moroz-matros/badminton_training_diplom/наброски/cyclops.jpg

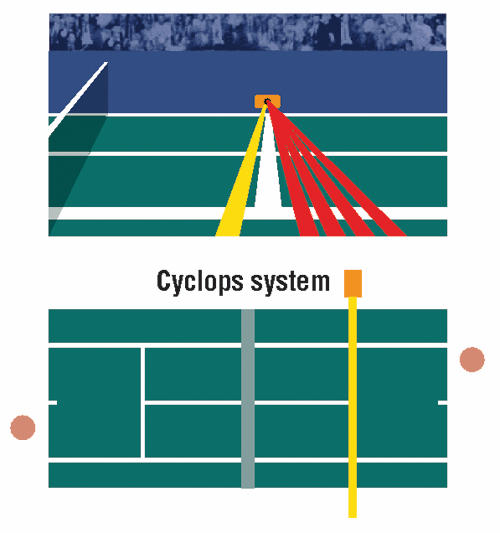
наброски/cyclops.jpg
