moroz-matros/badminton_training_diplom/курсовая/Безымянный.png

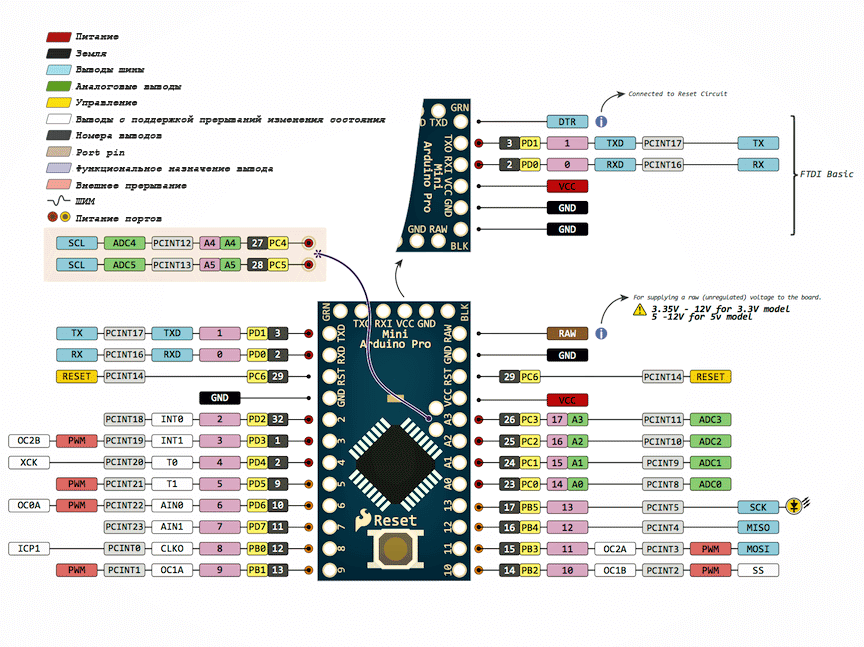
курсовая/Безымянный.png
