moroz-matros/badminton_training_diplom/README.md

# badminton_training_diplom

список материалов - https://docs.google.com/spreadsheets/d/1XVWoqVWHNPgPeewf001gxFfqlMmKqkPSv3BXijBLTfs/edit?usp=sharing
Опросы в процессе
