moroz-matros/badminton_training_diplom/прототип и практика/отчет_v1.docx

СОДЕРЖАНИЕ

Введение.......................................................................................................................4

Основная часть.............................................................................................................5

1 Проектирование и сборка макетного образца.............................................5

  1.1 Микроконтроллер ATmega328.........................................................5
  1.2 Чувствительный к давлению мат.....................................................6
  1.3 Пайка элементов................................................................................7
  1.4 Сборка схемы.....................................................................................7

2 Программирование макетного образца........................................................9

Заключение.................................................................................................................10

Список использованных источников.......................................................................11

ВВЕДЕНИЕ

В настоящее время сложно представить современный мир без повсеместного использования различных систем с датчиками — двери в торговых центрах открываются автоматически при приближении человека, а система «умный дом» уже не является чем-то необычным. Часто встречаются и системы с датчиками, воспринимающими нажатия, приложенное давление.

Целью данной практики является разработка макетного образца чувствительного мата на основе материала Velostat®.

Для достижения данной цели были поставлены следующие задачи:

1. Ознакомиться с процессом пайки электронных компонентов, изучить технику безопасности;
2. На основе медной ленты и материала Velostat® собрать макетный образец чувствительного мата, подключить его к микроконтроллеру.
3. Запрограммировать микроконтроллер на заданное в техническом задании поведение.

ОСНОВНАЯ ЧАСТЬ

1 Проектирование и сборка макетного образца

Макетный образец состоит из двух частей — самого мата и микроконтроллера, определяющего его поведение.

  1.1 Микроконтроллер ATmega328

Существует огромное множество различных микроконтроллеров. Однако работать непосредственно только с микросхемой может быть затруднительно, поэтому часто встречаются уже готовые модули на плате.

Одной из наиболее известных марок в этой области является Arduino. Она предоставляет программную оболочку для написания программ и аппаратную часть, включающую в себя набор смонтированных печатных плат. По Arduino есть большое количество теоретического материала, сторонние производители также выпускают различные датчики и другие периферийные устройства, которые ориентированы на подключение к устройствам данной марки. Поэтому было принято решение использовать их.

В классической линейке устройств в основном применяются микроконтроллеры семейства Atmel AVR — ATmega2560, ATmega32U4, ATmega328, ATtiny85, ATmega168. В данной работе было решено использовать плату с микроконтроллером ATmega328.

ATmega328 — 8-битный микроконтроллер с низким энергопотреблением, созданный по КМОП технологии. В нем используется усовершенствованная компанией AVR RISC архитектура, предполагающая сокращение числа команд.

Этот микроконтроллер используется в платформе Arduino Pro Mini, в данной работе была использована именно она. Среди остальной линейки серии она отличается маленьким размером. Также Arduino Pro Mini отличается удовлетворительным соотношением цены к техническим требованиям для разработанного мата.

Данная плата обладает характеристиками, представленными в таблице 1.

Таблица 1 — Характеристики платформы Arduino Pro Mini

Характеристика | Значение
Рабочее напряжение | 5 В
Входное напряжение | 5-12 В
Цифровые входы/выходы | 14 (6 из которых могут использоваться как выходы ШИМ
Аналоговые входы | 6
Постоянный ток через вход/выход | 40 мА
Флеш-память | 16 Кб (2 используются для загрузчика)
ОЗУ | 1 Кб
EEPROM | 512 байт
Тактовая частота | 16 МГц

Питание платы в данной работе осуществляется от компьютера с помощью переходника USB в TTL.

Внешний вид платы представлен на рисунке 1.

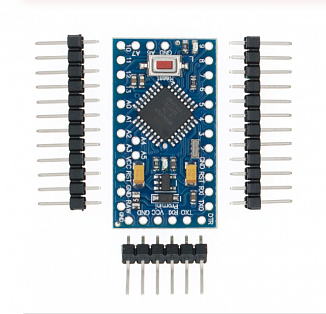
[picture p3: figure]

Рисунок 1 — Внешний вид контроллера Arduino Pro Mini

  1.2 Чувствительный к давлению мат

Velostat® представляет собой непрозрачную объемно-проводящую пленку, наполненную полиолефином. Активное сопротивление материала уменьшается при приложении давления. Если материал расположить между двумя проводящими слоями, можно использовать его в качестве датчика давления.

В качестве проводящих слоев использована лента из меди, которая обычно используется как электрический проводник.

Таким образом, строение мата представляет из себя следующее: лист материала Velostat® располагается между рядами лент из меди. К листам меди припаиваются провода. К одному слою поступает питание, провода со второго слоя поступают на аналоговые входы собранной схемы.

Таким образом, схема самого мата выглядит примерно так, как представлено на рисунке 2.

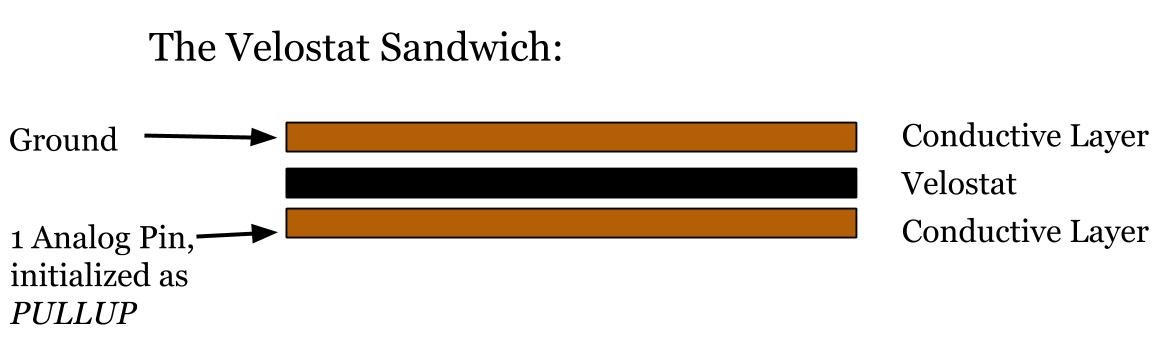
[picture p4: figure]

Рисунок 2 — Основа макетного образца мата

Однако у Arduino Pro Mini есть только 6 аналоговых входов. Для увеличения их количества было принято решение использовать мультиплексор и демультиплексор.

Наиболее часто используемой в системах Arduino микросхемой является 16-канальный мультиплексор/демультиплексор CD74HC4067. Он также поставляется на плате, что облегчает его подключение к микроконтроллеру Arduino. Внешний вид CD74HC4067 представлен на рисунке 3.

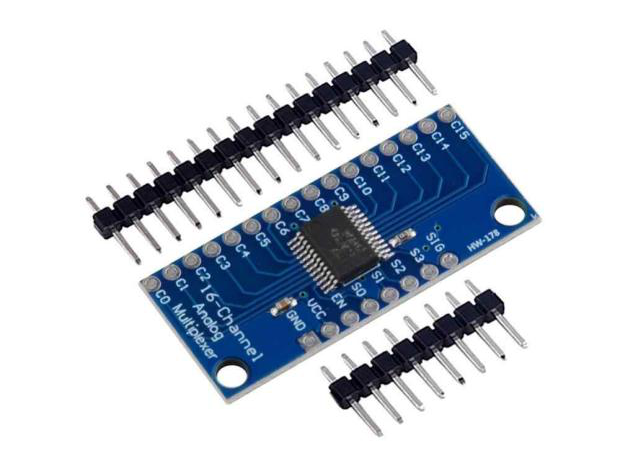
[picture p5: figure]

Рисунок 3 — 16-канальный мультиплексор/демультиплексор CD74HC4067

Технические параметры устройства (рабочая температура, напряжение питания) подходят под условия разработанного макетного образца.

1.3 Пайка элементов

Пайка — технологическая операция, применяемая для получения неразъёмного соединения деталей из различных материалов путём введения между этими деталями расплавленного материала (припоя), имеющего более низкую температуру плавления, чем материал (материалы) соединяемых деталей.

Во время пайки в воздух выделяются такие вредные вещества, как свинец, цинк и др., поэтому место работы должно хорошо проветриваться.

Необходимо было спаять следующие элементы:

1. Провода и штыревые соединители;
2. Провода и медную ленту;
3. Плату Arduino и штыревые соединители.

В процессе пайки использовался припой оловянно-свинцовый с флюсом (Sn63/Pb37, содержание флюса: 2%).

1.4 Сборка схемы

После выполнения пайки элементов необходимо было собрать схему устройства. Для удобства использовали макетную плату, изображение которой представлено на рисунке 4.

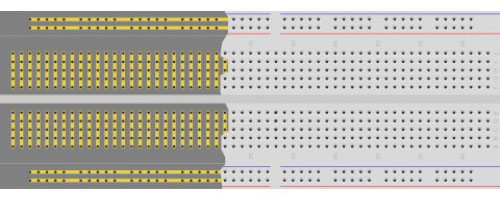
[picture p6: figure]

Рисунок 4 — Макетная плата на 830 контактов и её внутреннее строение

Принцип работы устройства следующий: с выходов платы микроконтроллера на 16-канальный аналоговый мультиплексор/демультиплексор CD74HC4067, работающий в режиме демультиплексора, поступают сигналы S0_OUTPUT...S3_OUTPUT и SIG_OUTPUT. С помощью первых четырех сигналов выбирается один из 16 C0_OUTPUT...C15_OUTPUT, на который будет подаваться сигнал SIG_OUTPUT. К выходам C0_OUTPUT..C11_OUTPUT подключены 12 линий медной ленты. Ток проходит по ленте через Velostat® и поступает на другие 12 линий медной ленты, которые подсоединены к выходам C0_INPUT...C11_INPUT мультиплексора. С помощью сигналов S0_INPUT...S3_INPUT аналогично производится выбор нужного канала, сигнал с которого через выход SIG_INPUT поступает на вход платы микроконтроллера.

Таким образом, выбирав нужный канал и зафиксировав изменение поступающего аналогового сигнала, можно отследить нажатия на собранный датчик.

2 Программирование макетного образца

Язык программирования Arduino называется Arduino C и представляет собой язык C++ (https://ru.wikipedia.org/wiki/C++) с фреймворком (https://ru.wikipedia.org/wiki/%D0%A4%D1%80%D0%B5%D0%B9%D0%BC%D0%B2%D0%BE%D1%80%D0%BA) Wiring (https://en.wikipedia.org/wiki/Wiring_(development_platform)) (https://ru.wikipedia.org/wiki/Arduino), Он имеет некоторые отличия по части написания кода, который компилируется и собирается с помощью avr-gcc (https://ru.wikipedia.org/wiki/GNU_Compiler_Collection), с особенностями, облегчающими написание работающей программы — имеется набор библиотек, включающий в себя функции и объекты.

Программирование микроконтроллера ATmega328 с помощью среды разработки Arduino IDE.

Все микроконтроллеры от Arduino имеют специальный загрузчик, созданный на основе Atmel AVR Application Note AN109. Этот загрузчик может работать через интерфейс USB, с его помощью производилось программирование.

Принцип работы системы был описан в пункте 1.4.

Схема алгоритма программного кода представлена на рисунке 6.

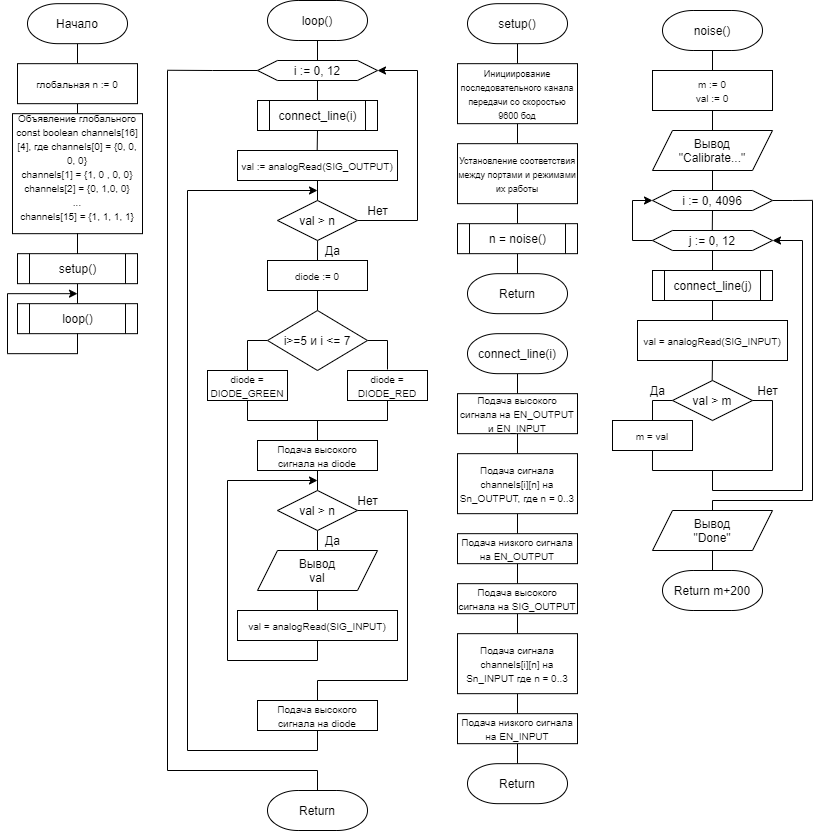
[picture p7: figure]
algo

Рисунок 6 — Схема алгоритма программного кода

Код программы представлен в листинге 1.

Листинг 1 — Код программы макетного образца

#define SIG_OUTPUT A1

#define S3_OUTPUT 13

#define S2_OUTPUT 12

#define S1_OUTPUT 11

#define S0_OUTPUT 10

#define EN_OUTPUT 4

#define SIG_INPUT A0

#define S3_INPUT 9

#define S2_INPUT 8

#define S1_INPUT 7

#define S0_INPUT 6

#define EN_INPUT 5

Продолжение листинга 1

#define DIODE_GREEN 3

#define DIODE_RED 2

int n = 0;

const boolean channels [16][4] {

{0, 0, 0, 0}, //channel 0

{1, 0, 0, 0}, //channel 1

{0, 1, 0, 0}, //channel 2

{1, 1, 0, 0}, //channel 3

{0, 0, 1, 0}, //channel 4

{1, 0, 1, 0}, //channel 5

{0, 1, 1, 0}, //channel 6

{1, 1, 1, 0}, //channel 7

{0, 0, 0, 1}, //channel 8

{1, 0, 0, 1}, //channel 9

{0, 1, 0, 1}, //channel 10

{1, 1, 0, 1}, //channel 11

{0, 0, 1, 1}, //channel 12

{1, 0, 1, 1}, //channel 13

{0, 1, 1, 1}, //channel 14

{1, 1, 1, 1} //channel 15

};

void setup() {

Serial.begin(9600);

pinMode(S0_OUTPUT, OUTPUT);

pinMode(S1_OUTPUT, OUTPUT);

pinMode(S2_OUTPUT, OUTPUT);

pinMode(S3_OUTPUT, OUTPUT);

pinMode(S0_INPUT, OUTPUT);

pinMode(S1_INPUT, OUTPUT);

pinMode(S2_INPUT, OUTPUT);

pinMode(S3_INPUT, OUTPUT);

pinMode(EN_OUTPUT, OUTPUT);

pinMode(EN_INPUT, OUTPUT);

pinMode(SIG_OUTPUT, OUTPUT);

pinMode(SIG_INPUT, INPUT);

pinMode(DIODE_RED, OUTPUT);

pinMode(DIODE_GREEN, OUTPUT);

n = noise();

}

void loop() {

//необходимо пройтись по всем портам S0..S3 выхода и подать на C0..C11 (C16) платы питания высокий сигнал

Продолжение листинга 1

for (int i = 0; i < 12; i++) {

connect_line(i);

int val = analogRead(SIG_INPUT);

if (val > n) {

int diode = 0;

if ((i >= 5) && (i <= 7)){

diode = DIODE_GREEN;

} else {

diode = DIODE_RED;

}

digitalWrite(diode, HIGH);

while (val > n) {

Serial.print(val);

Serial.print(" ");

Serial.println(n);

val = analogRead(SIG_INPUT);

}

digitalWrite(diode, LOW);

}

}

}

int noise() {

int m = 0;

int val = 0;

Serial.println("Calibrate...");

for (int i = 0; i < 4096; i++) {

for (int j = 0; j < 12; j++) {

connect_line(j);

val = analogRead(SIG_INPUT);

if (val > m) {

m = val;

}

}

}

Serial.println("Done");

return m+200;

}

void connect_line(int i) {

digitalWrite(EN_OUTPUT, HIGH);

digitalWrite(EN_INPUT, HIGH);

digitalWrite(S0_OUTPUT, channels[i][0]);

digitalWrite(S1_OUTPUT, channels[i][1]);

digitalWrite(S2_OUTPUT, channels[i][2]);

digitalWrite(S3_OUTPUT, channels[i][3]);

digitalWrite(EN_OUTPUT, LOW);

digitalWrite(SIG_OUTPUT, HIGH);

Продолжение листинга 1

digitalWrite(S0_INPUT, channels[i][0]);

digitalWrite(S1_INPUT, channels[i][1]);

digitalWrite(S2_INPUT, channels[i][2]);

digitalWrite(S3_INPUT, channels[i][3]);

digitalWrite(EN_INPUT, LOW);

}

ЗАКЛЮЧЕНИЕ

В ходе прохождения практики были достигнуты поставленные цели и выполнены следующие задачи:

1. Произведено ознакомление с процессом пайки электронных компонентов, изучена техника безопасности;
2. На основе медной ленты и материала Velostat® был собран датчик давления. Датчик был подключен к микроконтроллеру ATmega328 линейки Arduino.
3. Микроконтроллер запрограммирован на заданное в техническом задании поведение.

Отчет был оформлен в соответствии с ГОСТ 7.32-2017.

СПИСОК ИСПОЛЬЗОВАННЫХ ИСТОЧНИКОВ

1. ГОСТ 7.32-2017. Отчет о научно-исследовательской работе. Структура и правила оформления.
2. Справочник по пайке / Ред. Петрунин И. Е. - 2-е изд., перераб. и дополн. - М. : Машиностроение, 1984. - 398 с.
3. Портал магистров ДонНТУ. Реферат по теме выпускной работы Куксина И.Ю. — URL: https://masters.donntu.org/2013/etf/kuksin/diss/index.htm (дата обращения 2021-07-02)
4. Alterozoom. Velostat. — URL: https://alterozoom.com/ru/documents/43822.html (дата обращения 2021-07-02)
5. Arduino. — URL: https://www.arduino.cc/ (дата обращения 2021-07-12)
6. Arduino.ru. — http://arduino.ru/ (дата обращения 2021-07-12)
7. E-Portfolio for Robotics 243 Workshop Spring 2015. — URL: https://www.sites.google.com/a/mtholyoke.edu/cs-243-spring-15-barkh22g/home (дата обращения 2021-07-02)
