moroz-matros/badminton_training_diplom/наброски/список_использованных_источников.docx

СПИСОК ИСПОЛЬЗОВАННЫХ ИСТОЧНИКОВ

1. TOPSPIN.PRO [Электронный ресурс]. — URL: https://topspin.pro/market/badminton_pushki/ (дата обращения 2022-02-10)
2. Коновалов И.Е. Технология формирования тактико-технических навыков спортсменов в теннисе и бадминтоне с помощью устройств дополненной реальности / И.Е. Коновалов, В.Е. Афоньшин, М.М. Полевщиков // Наука и спорт: современные тенденции. – 2020. – Т. 8, № 1. – С. 19-24. DOI: 10.36028/2308-8826-2019-8-1-19-24
3. The Tech Race. S1 - EP 29 - 20:20 vision: A clear view of Badminton technology (https://olympics.com/en/original-series/episode/20-20-vision-a-clear-view-of-badminton-technology) [Электронный ресурс]. — URL: https://olympics.com/en/original-series/episode/20-20-vision-a-clear-view-of-badminton-technology (дата обращения 2022-02-11)
4. Shreeharsh Kelkar. The Power of Sight: The Case of Hawk-Eye in Tennis (англ.). — 2012. — 14 p.
5. Badminton: How to play, rules, and all you need to know. By Olympic Channel [Электронный ресурс]. — URL: https://olympics.com/en/featured-news/badminton-guide-how-to-play-rules-olympic-history (дата обращения 2022-02-13)
6. Портал магистров ДонНТУ. Реферат по теме выпускной работы Куксина И.Ю. [Электронный ресурс]. — URL: https://masters.donntu.org/2013/etf/kuksin/diss/index.htm (дата обращения 2021-09- 02)
7. Документация на Arduino Pro Mini [Электронный ресурс]. — URL: https://docs.arduino.cc/retired/boards/arduino-pro-mini (дата обращения 2021-10-01)
8. Документация на ATMega328P [Электронный ресурс]. — URL: https://www.microchip.com/content/dam/mchp/documents/MCU08/ProductDocuments/DataSheets/Atmel-7810-Automotive-Microcontrollers-ATmega328P_Datasheet.pdf (дата обращения 2021-10-01)
9. Документация на CD74HC4067 [Электронный ресурс]. — URL: https://www.ti.com/lit/ds/symlink/cd74hc4067.pdf (дата обращения 2021-10-01)
10. Документация на GNL-3012HD [Электронный ресурс]. — URL: https://static.chipdip.ru/lib/773/DOC002773602.pdf (дата обращения 2021-10-01)
11. Документация на резисторы MF [Электронный ресурс]. — URL: https://static.chipdip.ru/lib/336/DOC014336148.pdf (дата обращения 2021-10-01)
12. Документация на резисторы СF [Электронный ресурс]. — URL: https://static.chipdip.ru/lib/336/DOC014336146.pdf (дата обращения 2021-10-01)
13. Документация на HC-05 [Электронный ресурс]. — URL: http://wiki.amperka.ru/_media/продукты:troyka-bluetooth:troyka-bluetooth_datasheet.pdf (дата обращения 2021-10-01)
14. Электронный модуль «Bluetooth модуль HC-05». Технические данные и руководство пользователя [Электронный ресурс]. — URL: https://academy.evolvector.ru/baza/datasheet/%D0%9F%D0%AD%D0%9C100061-Bluetooth.pdf (дата обращения 2021-10-01)
15. Самые популярные операционные системы мира 2020 [Электронный ресурс]. — URL: https://marketer.ua/stats-operating-system-2020/ (дата обращения 2022-02-10)
16. Android Developers [Электронный ресурс]. — URL: https://developer.android.com/ (дата обращения 2022-02-10)
17. Как выбрать язык программирования для создания Андроид — приложения [Электронный ресурс]. — URL: https://habr.com/ru/post/477578/ (дата обращения 2022-02-10)
18. Android Developers [Электронный ресурс]. — URL: https://developer.android.com/ (дата обращения 2022-02-12)
19. Kotlin vs Java [Электронный ресурс]. — URL: https://www.imaginarycloud.com/blog/kotlin-vs-java/#1 (дата обращения 2022-02-12)
20. Иванова Г.С., Ничушкина Т.Н. Тестирование программного обеспечения. Методические указания по выполнению лабораторной работы по дисциплине «Технология разработки программных систем». — 2019. — 13с.
22. ГОСТ 2.730-73. Единая система конструкторской документации. Обозначения условные графические в схемах. Приборы полупроводниковые.
23. ГОСТ 2.728-74. Единая система конструкторской документации. Обозначения условные графические в схемах. Резисторы, конденсаторы.
24. ГОСТ 2.710-81. Единая система конструкторской документации. Обозначения буквенно-цифровые в электрических схемах.
25. ГОСТ 2.755-87. Единая система конструкторской документации. Обозначения условные графические в схемах. Устройства коммутационные и контактные соединения.
26. ГОСТ 2.702-2011. Единая система конструкторской документации. Правила выполнения электрических схем.
27. ГОСТ 7.32-2017. Отчет о научно-исследовательской работе. Структура и правила оформления.
28. Android [Электронный ресурс]. — URL: https://www.android.com/ (дата обращения 2022-02-12)

https://www.youtube.com/watch?v=cT1xw9p7Xek

https://www.youtube.com/watch?v=0W7FqDBD7Ts

https://www.proquest.com/openview/b7639530b4d56040ad19f7377a0a700b/1.pdf?pq-origsite=gscholar&cbl=40505

Electronic linesmen (https://go.gale.com/ps/i.do?id=GALE|A12842873&sid=googleScholar&v=2.1&it=r&linkaccess=abs&issn=00256501&p=AONE&sw=w)

L O'Connor - Mechanical Engineering-CIME, 1992 - go.gale.com

http://tvskit.narod.ru/stati/stati21/stati21.html
