moroz-matros/badminton_training_diplom/наброски/спецификация_2.pdf

Поз. обозначение | Наименование | Кол. | Примечание
| Устройства коммутационные
SW1, SW2 | Кнопка с самовозвратом SW-B3U-1000P | 2
| Диоды
VD1 | Диод Шоттки IN5817 | 1
| Транзисторы
VT1, VT2 | Транзистор биполярный NPN MJD112-LGE | 2

Подп. дата

Инв. №

дубл. Взам. инв. №

Подп. и

дата

Программно-аппаратная система контроля попаданий волана в заданную зону бадминтонной площадки

Изм. Лист | | № докум. | Подп. | Дата
| | | | | Спецификация | Лит. | Лист | Листов
Пров. | Сотников А.А. | | | | | | 2 | 2

Инв. №

подл. Разраб. Морозова А.А

МГТУ им. Н.Э. Баумана
Кафедра ИУ6
Группа ИУ6-82Б
Н. контр. | Еремин О.Ю. Утв. | Формат А4
