moroz-matros/badminton_training_diplom/курсовая/func.png

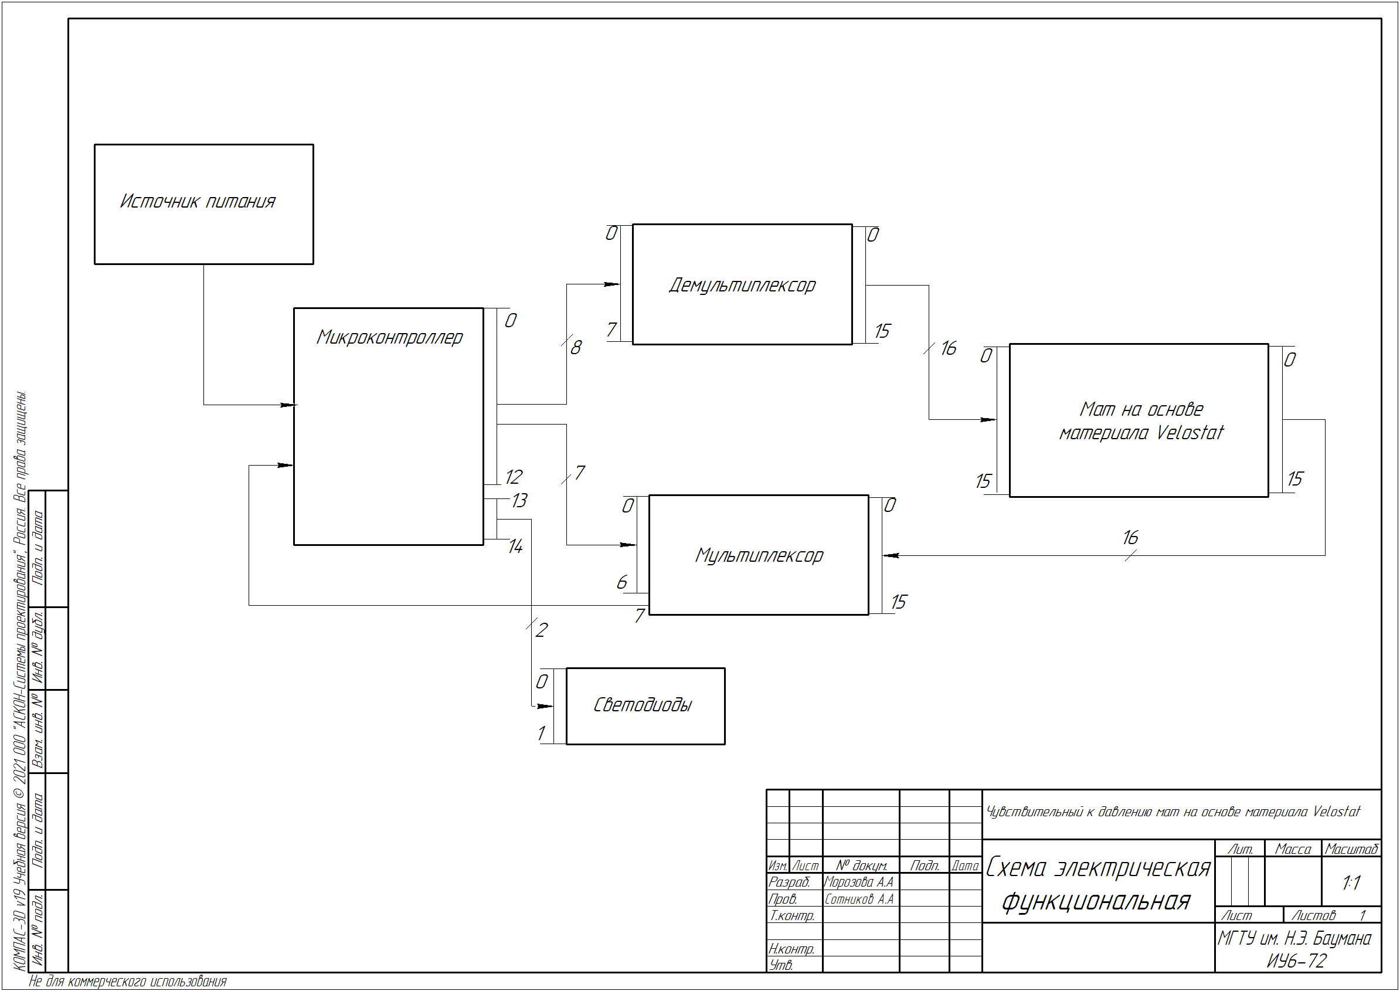
курсовая/func.png
