moroz-matros/badminton_training_diplom/курсовая/princ_v2.png

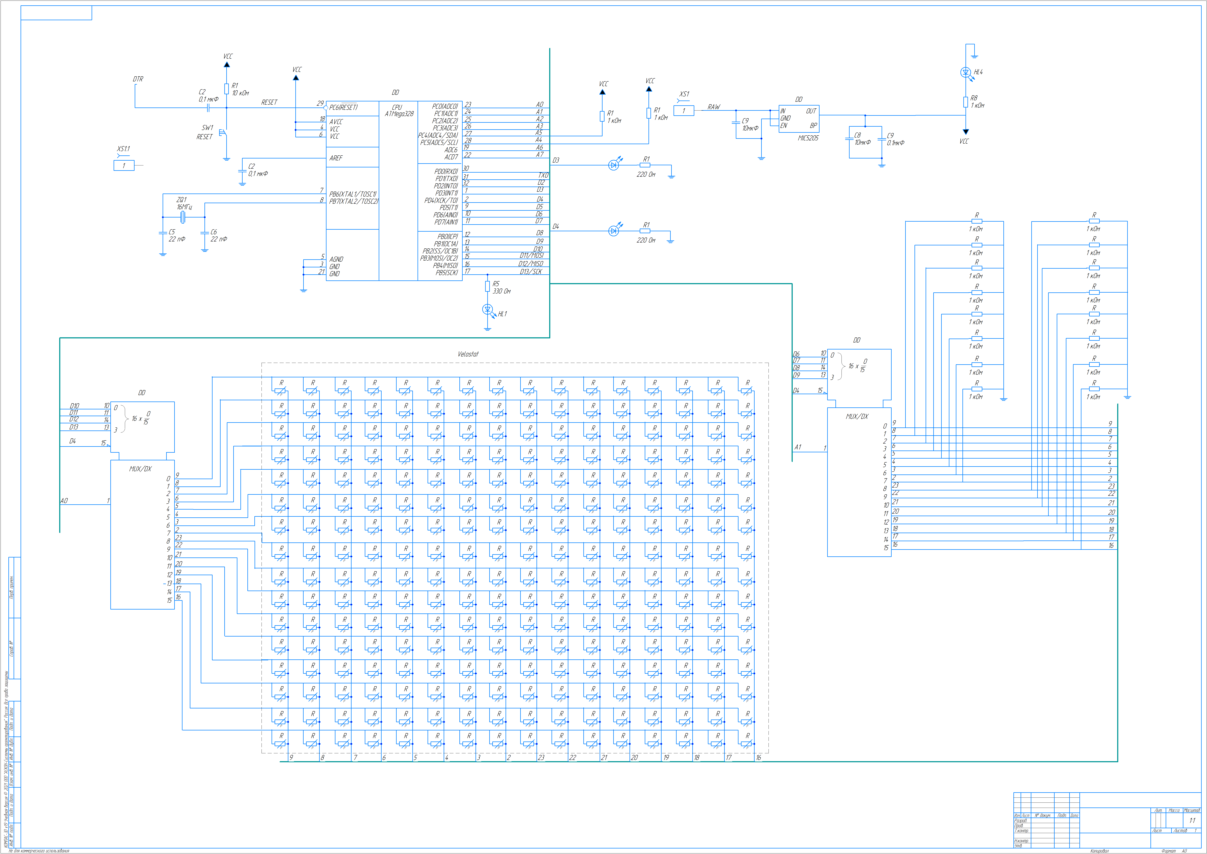
курсовая/princ_v2.png
