moroz-matros/badminton_training_diplom/курсовая/princ_v3.png

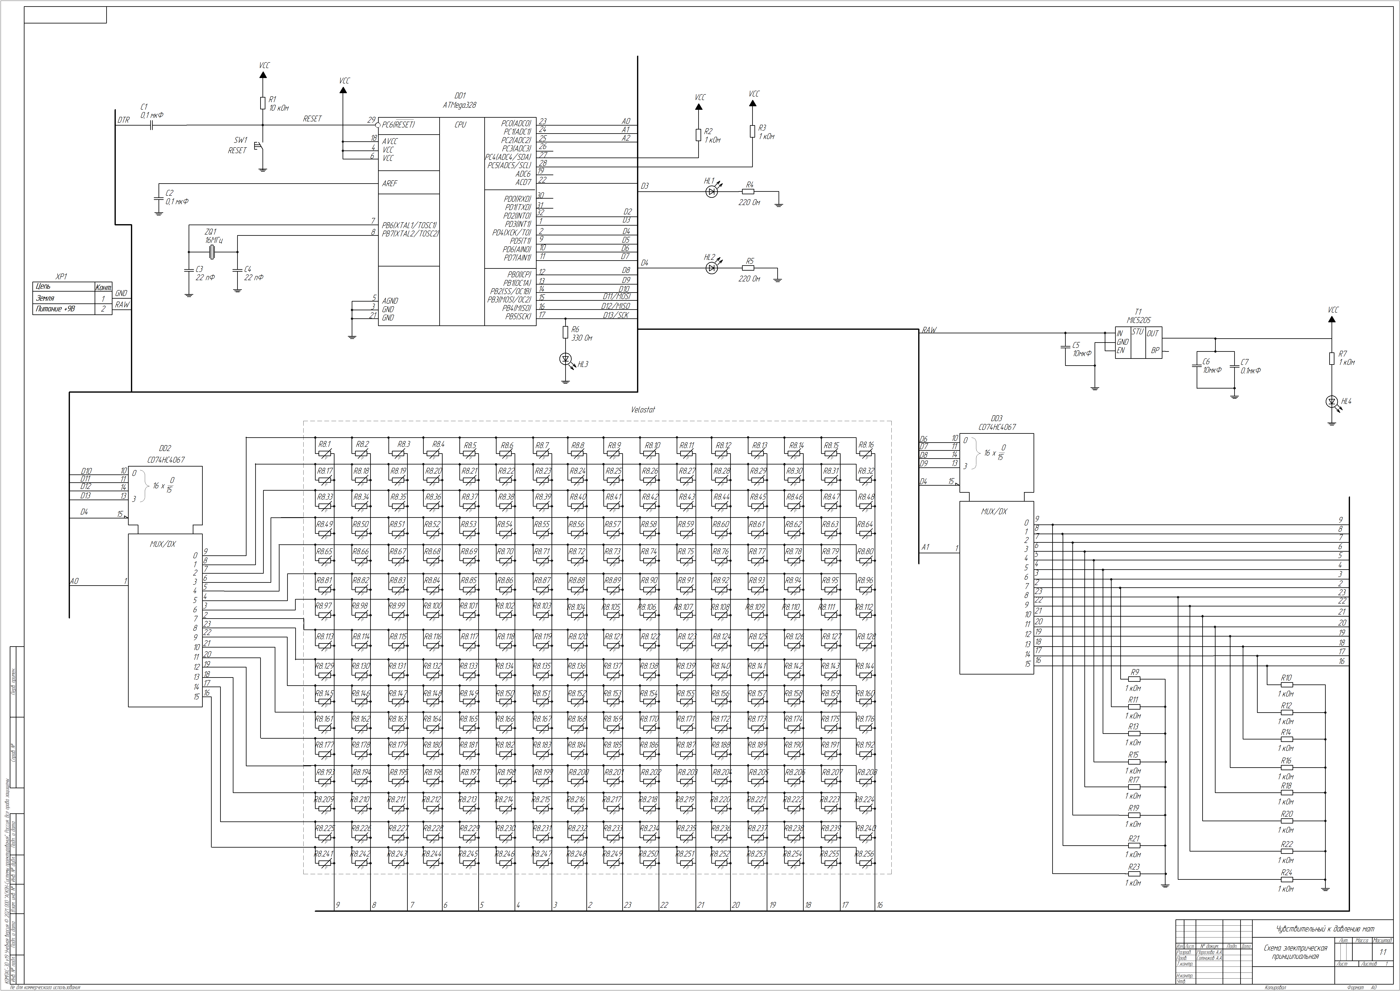
курсовая/princ_v3.png
