moroz-matros/badminton_training_diplom/курсовая/пример_структурная.png

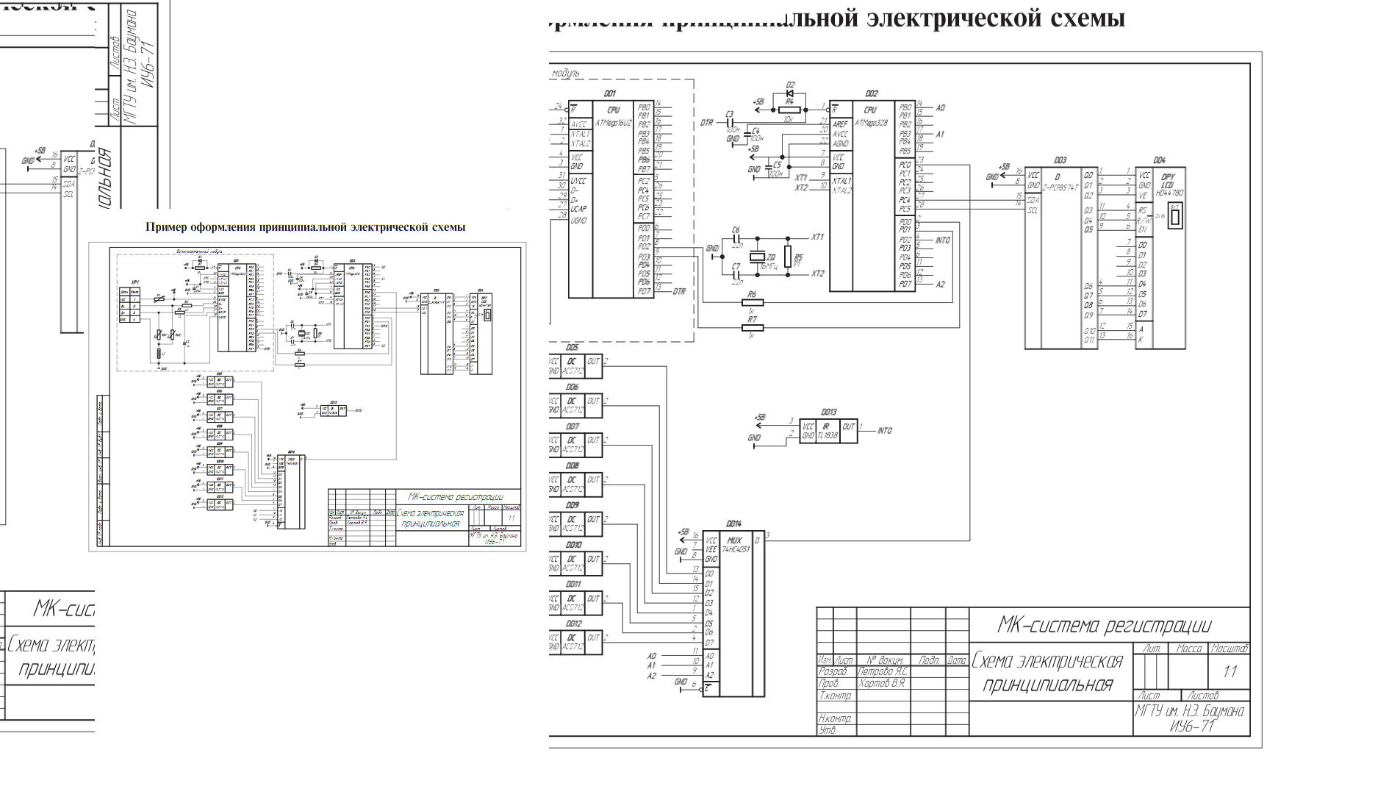
курсовая/пример_структурная.png
