moroz-matros/badminton_training_diplom/курсовая/пример_функциональная.png

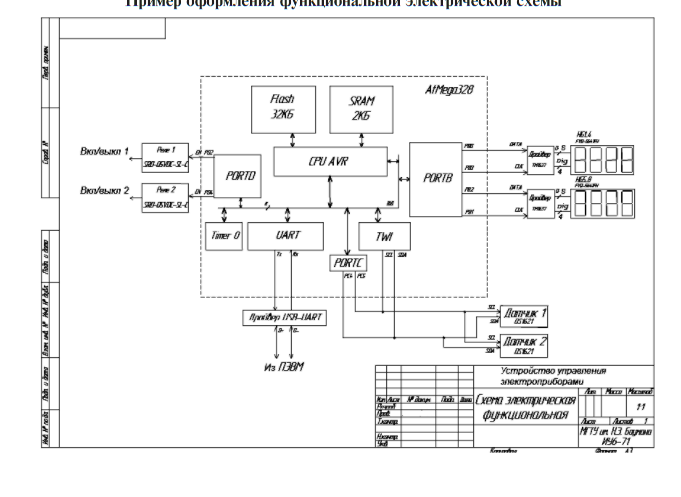
курсовая/пример_функциональная.png
