moroz-matros/badminton_training_diplom/курсовая/Снимок.PNG

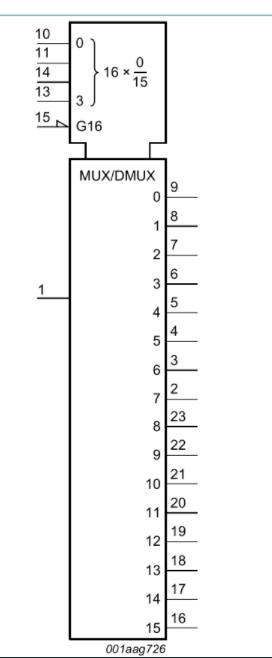
курсовая/Снимок.PNG
