moroz-matros/badminton_training_diplom/наброски/func.png

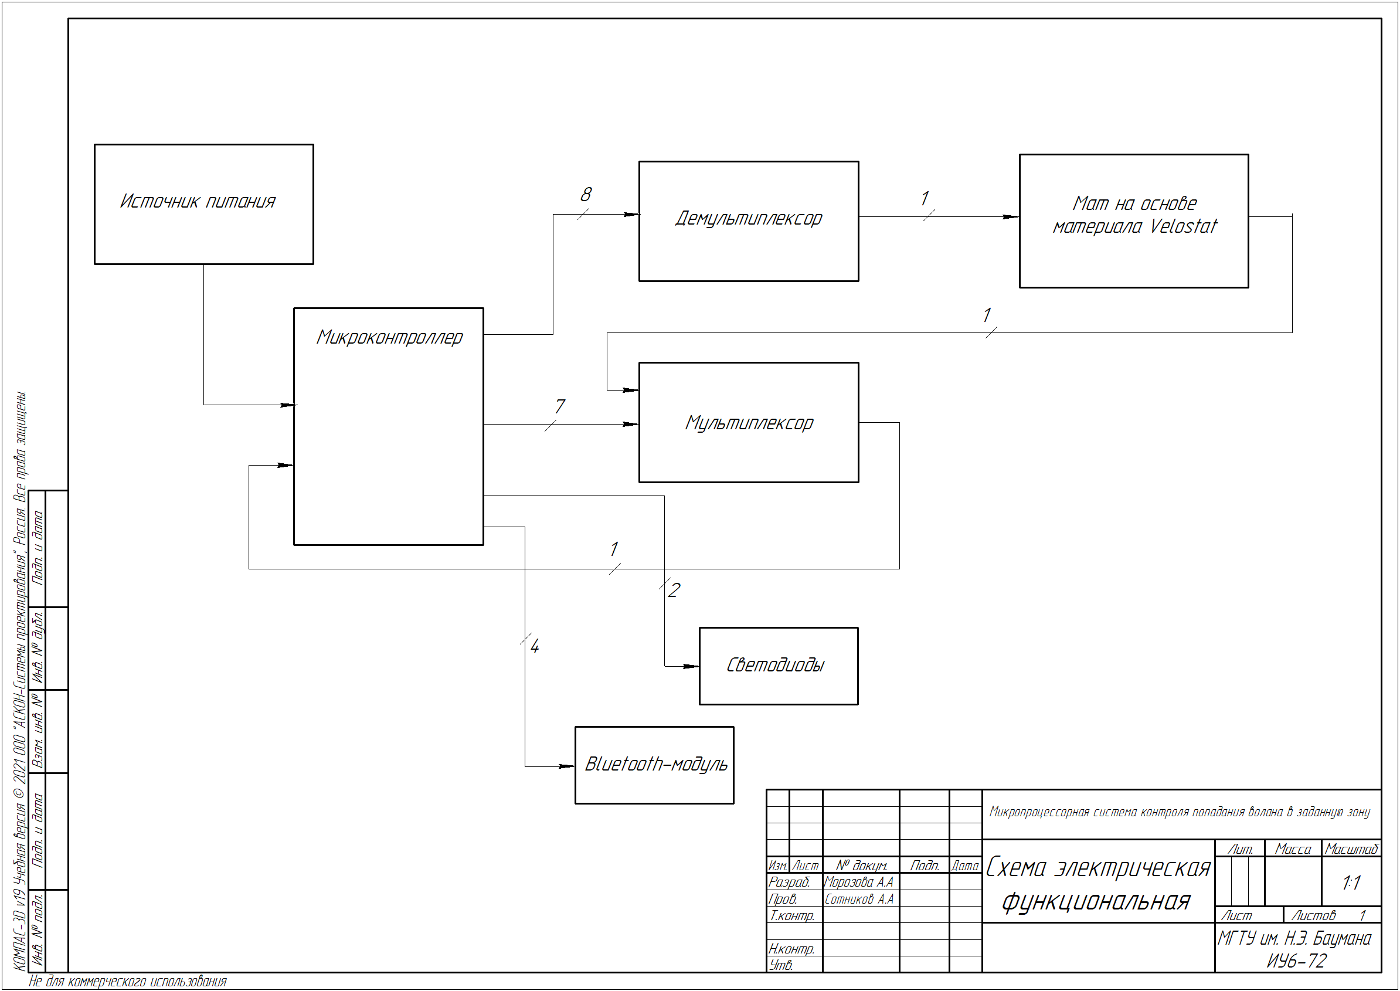
наброски/func.png
