moroz-matros/badminton_training_diplom/наброски/princ_v6.png

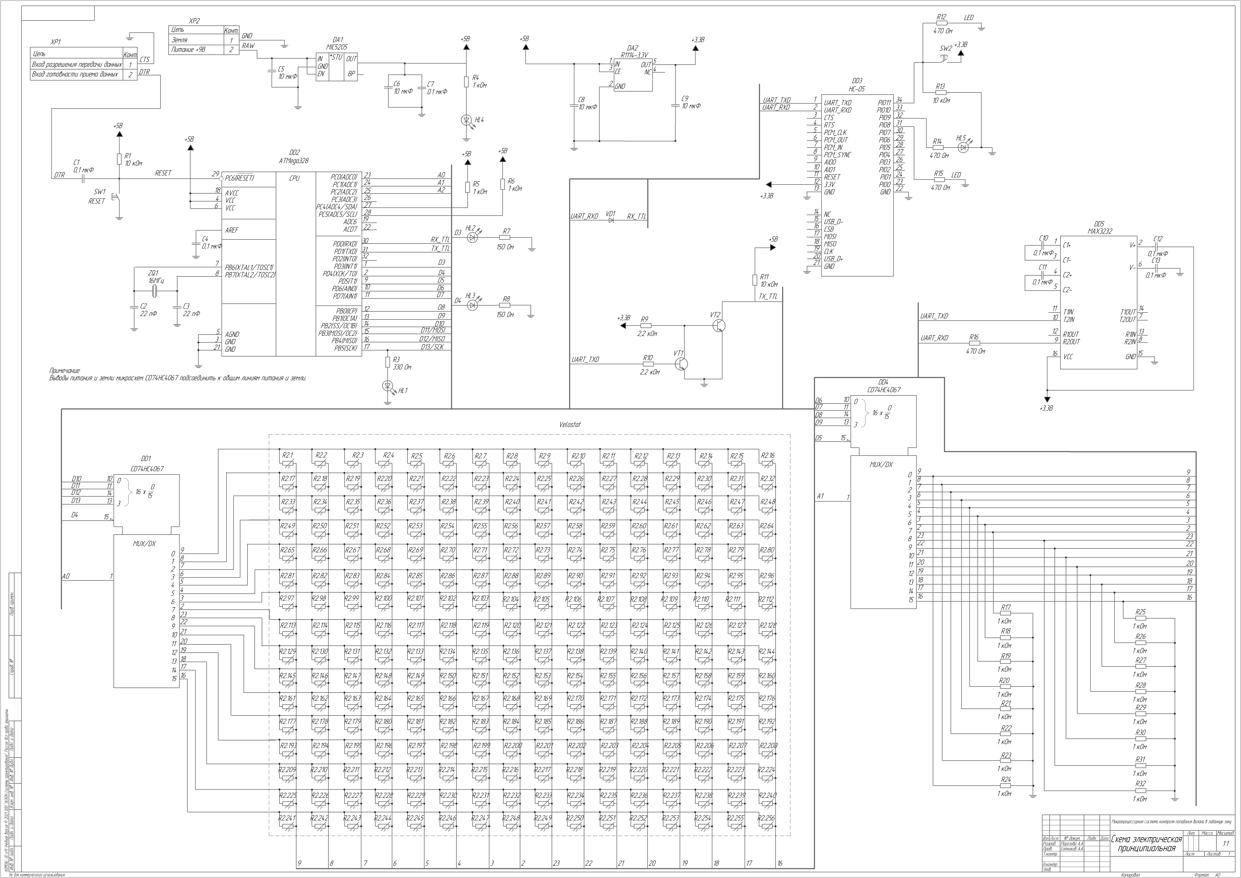
наброски/princ_v6.png
