moroz-matros/badminton_training_diplom/наброски/yotx.ru.png

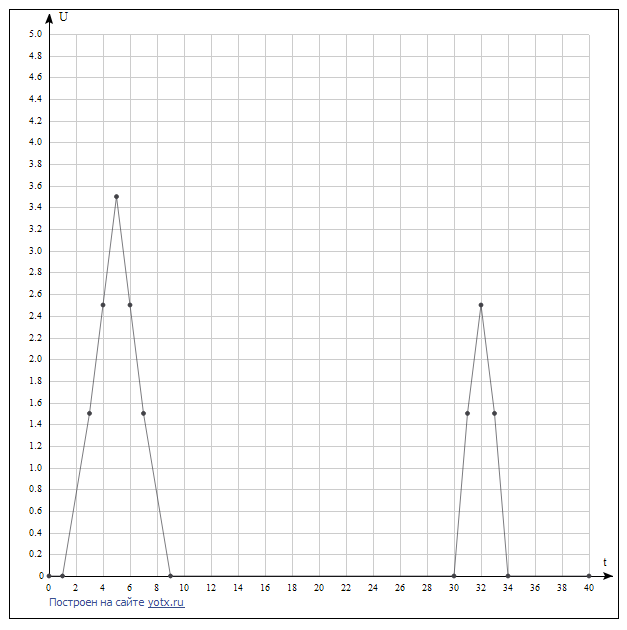
наброски/yotx.ru.png
