moroz-matros/badminton_training_diplom/наброски/конструкторский - алгоритмы.png

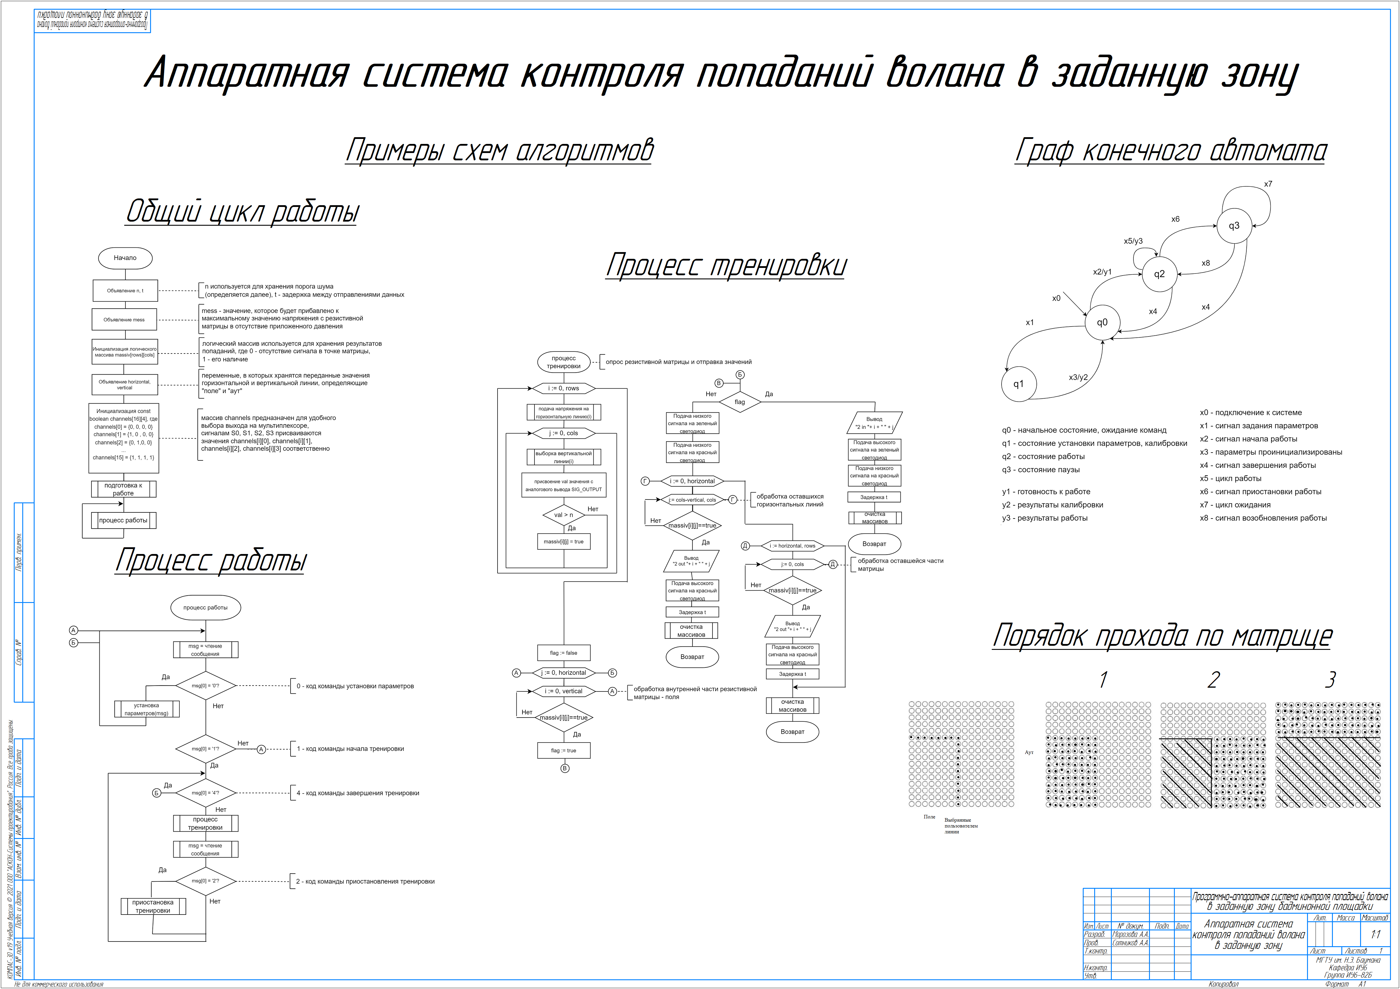
наброски/конструкторский - алгоритмы.png
