moroz-matros/badminton_training_diplom/наброски/конструкторский лист 1.png

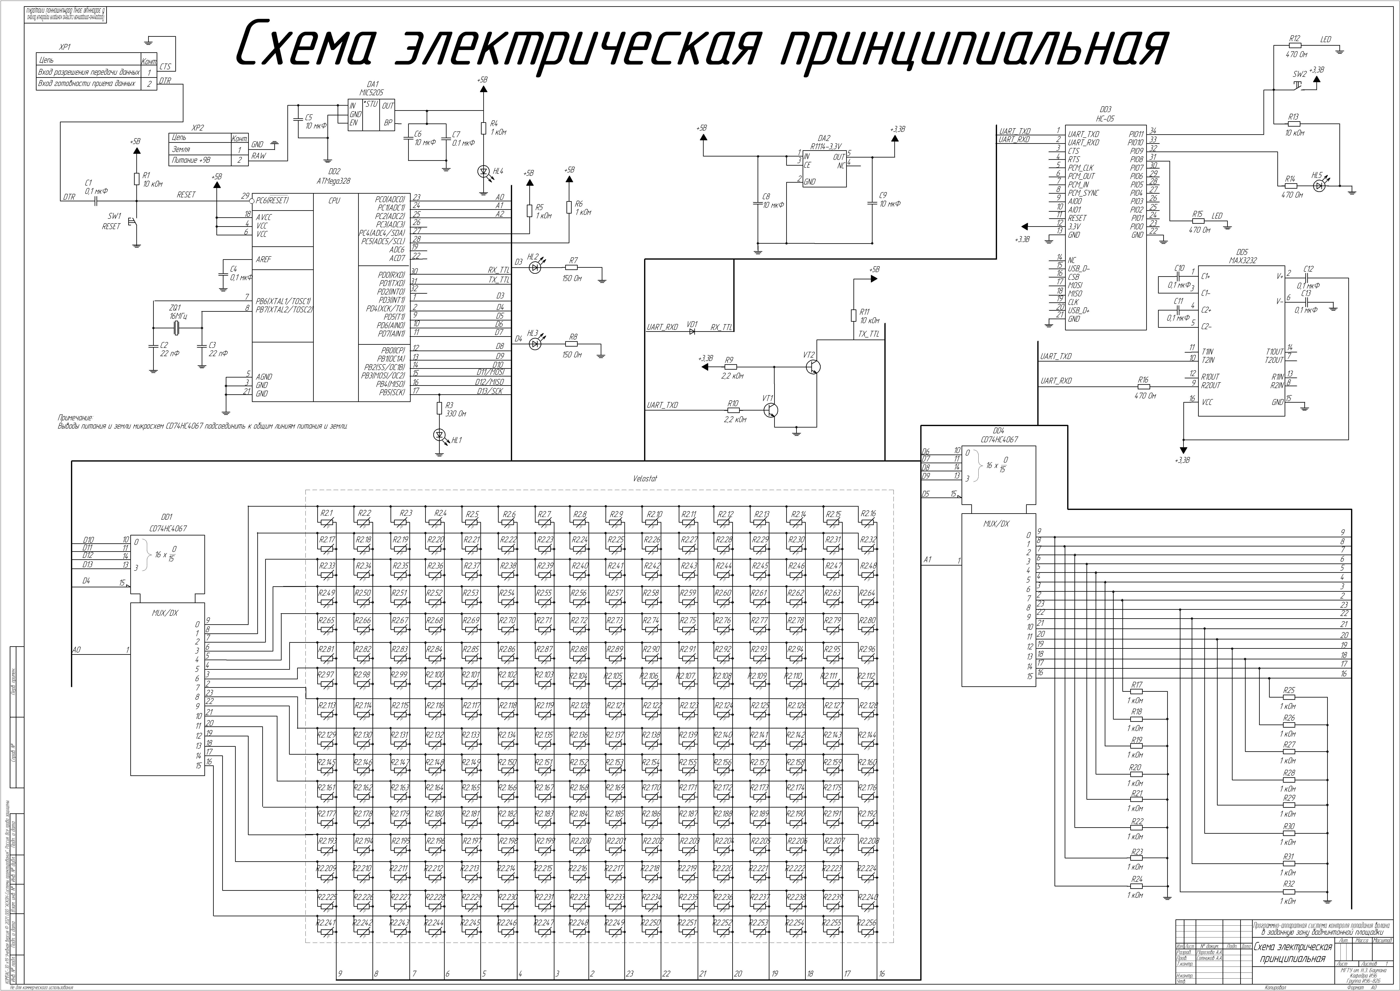
наброски/конструкторский лист 1.png
