moroz-matros/badminton_training_diplom/наброски/конструкторский — UML.png

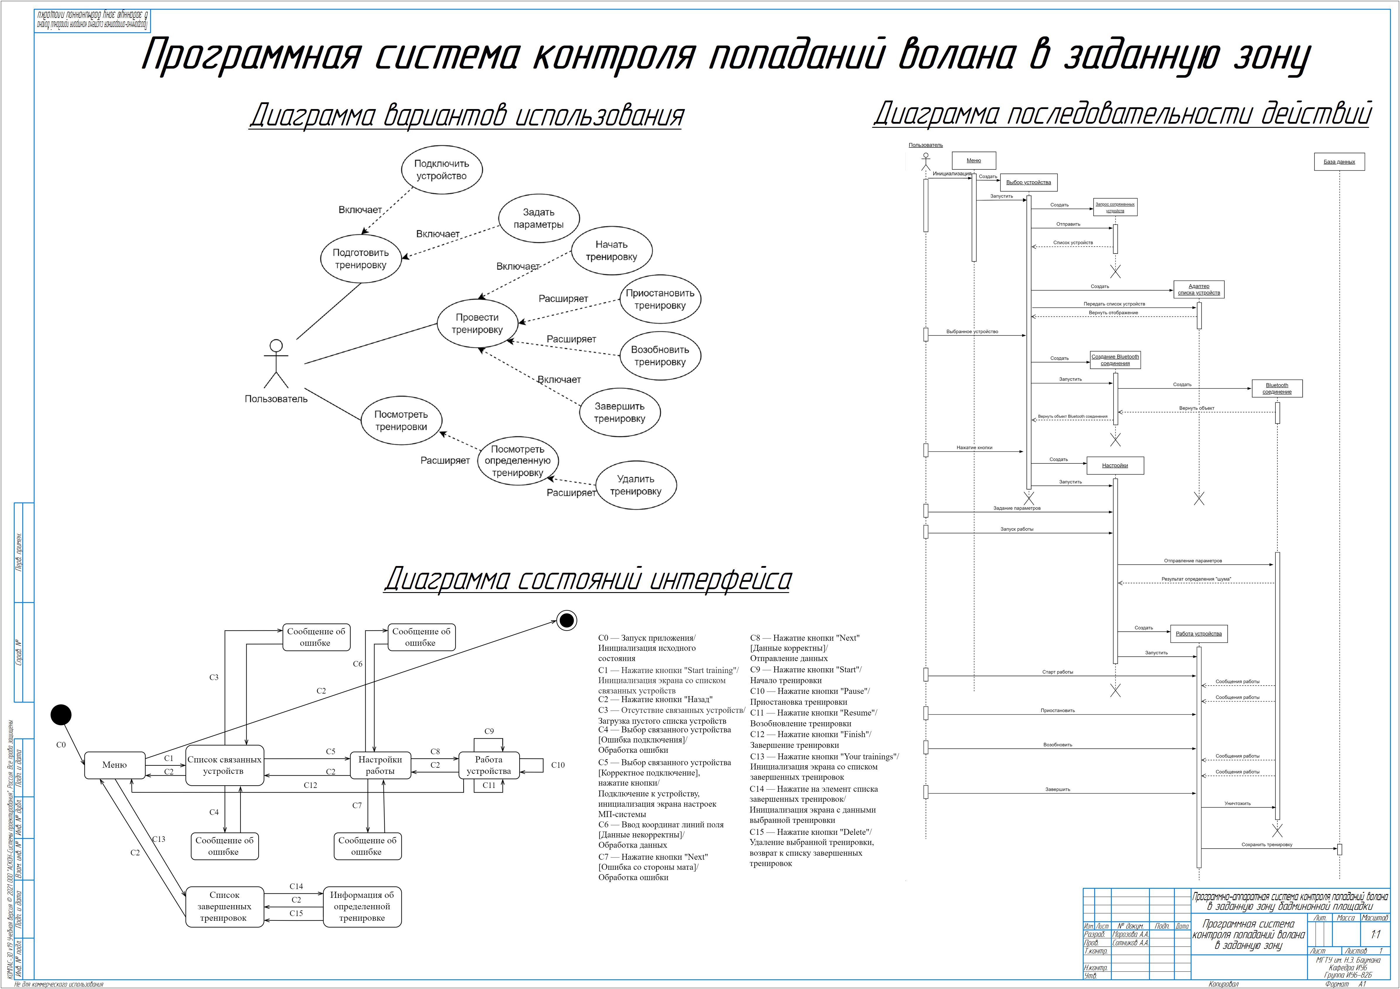
наброски/конструкторский — UML.png
