moroz-matros/badminton_training_diplom/наброски/конструкторский — интерфейсы.png

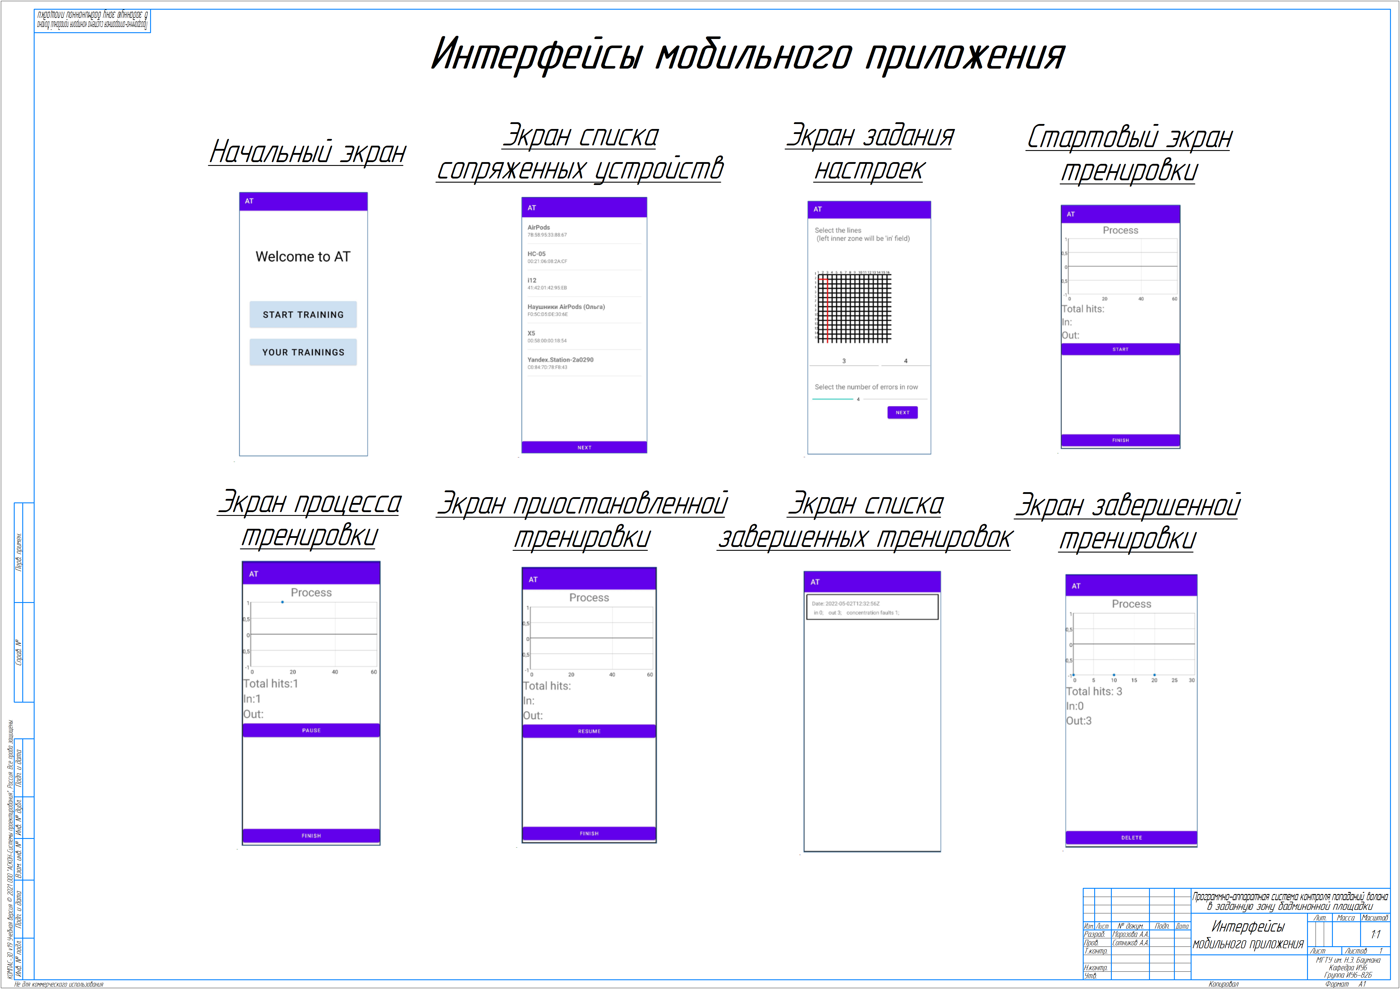
наброски/конструкторский — интерфейсы.png
