moroz-matros/badminton_training_diplom/наброски/падение.png

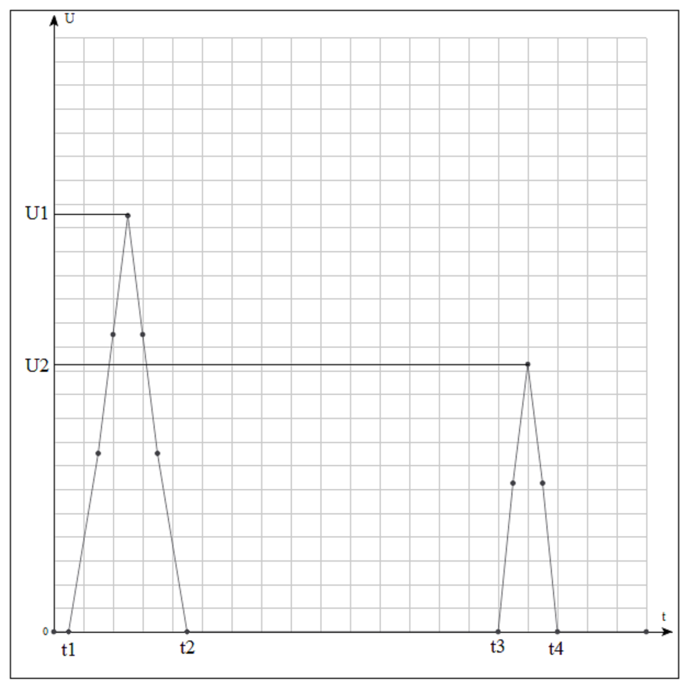
наброски/падение.png
