moroz-matros/badminton_training_diplom/наброски/постановочный лист.png

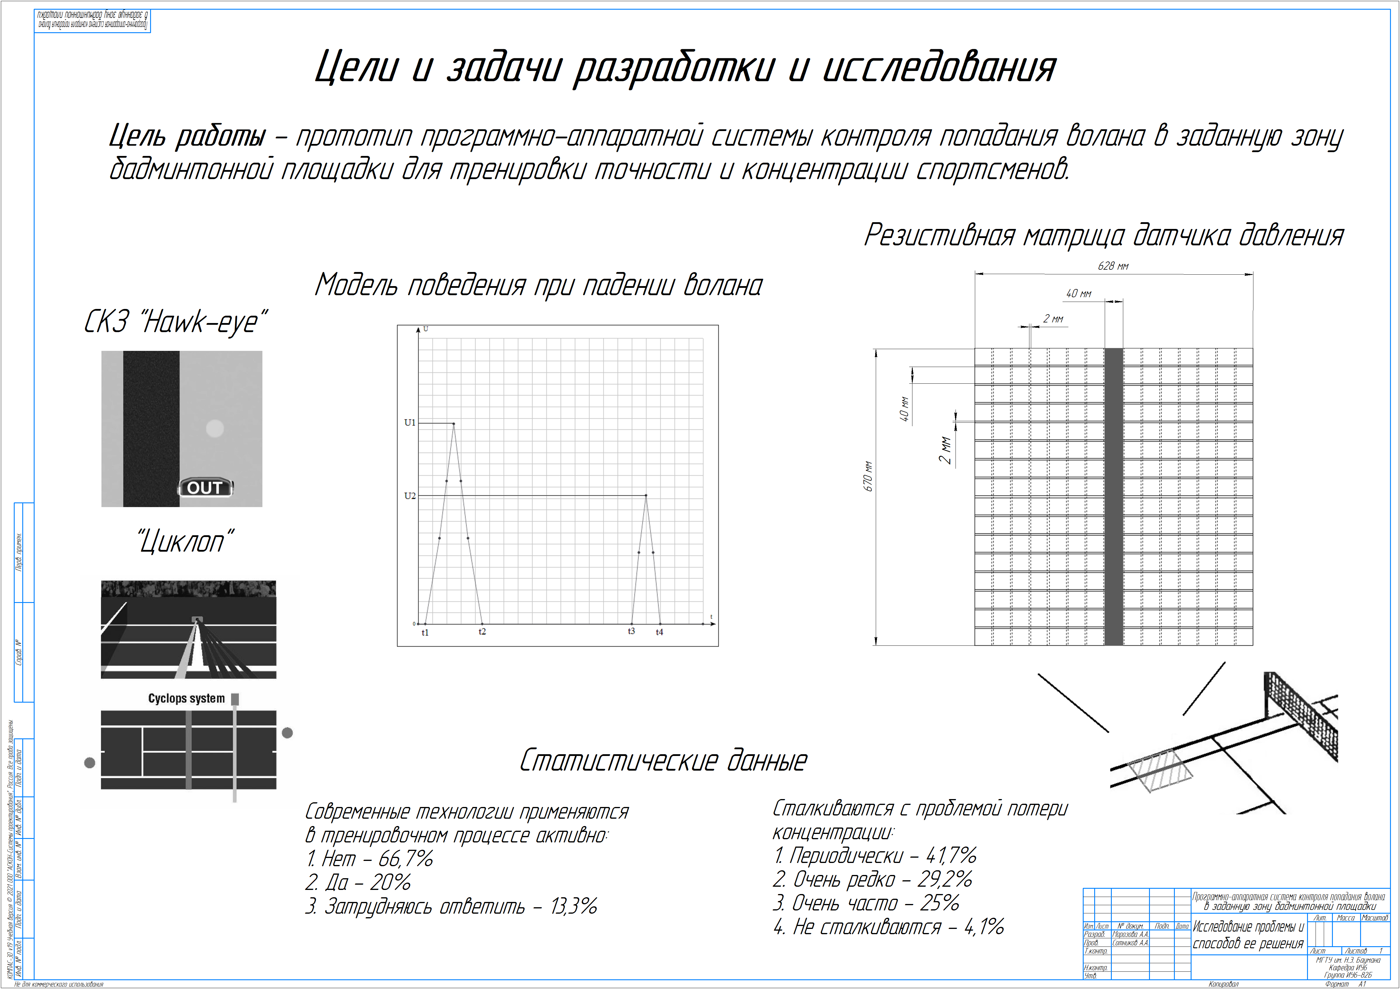
наброски/постановочный лист.png
