moroz-matros/badminton_training_diplom/наброски/принципиальная_а1.png

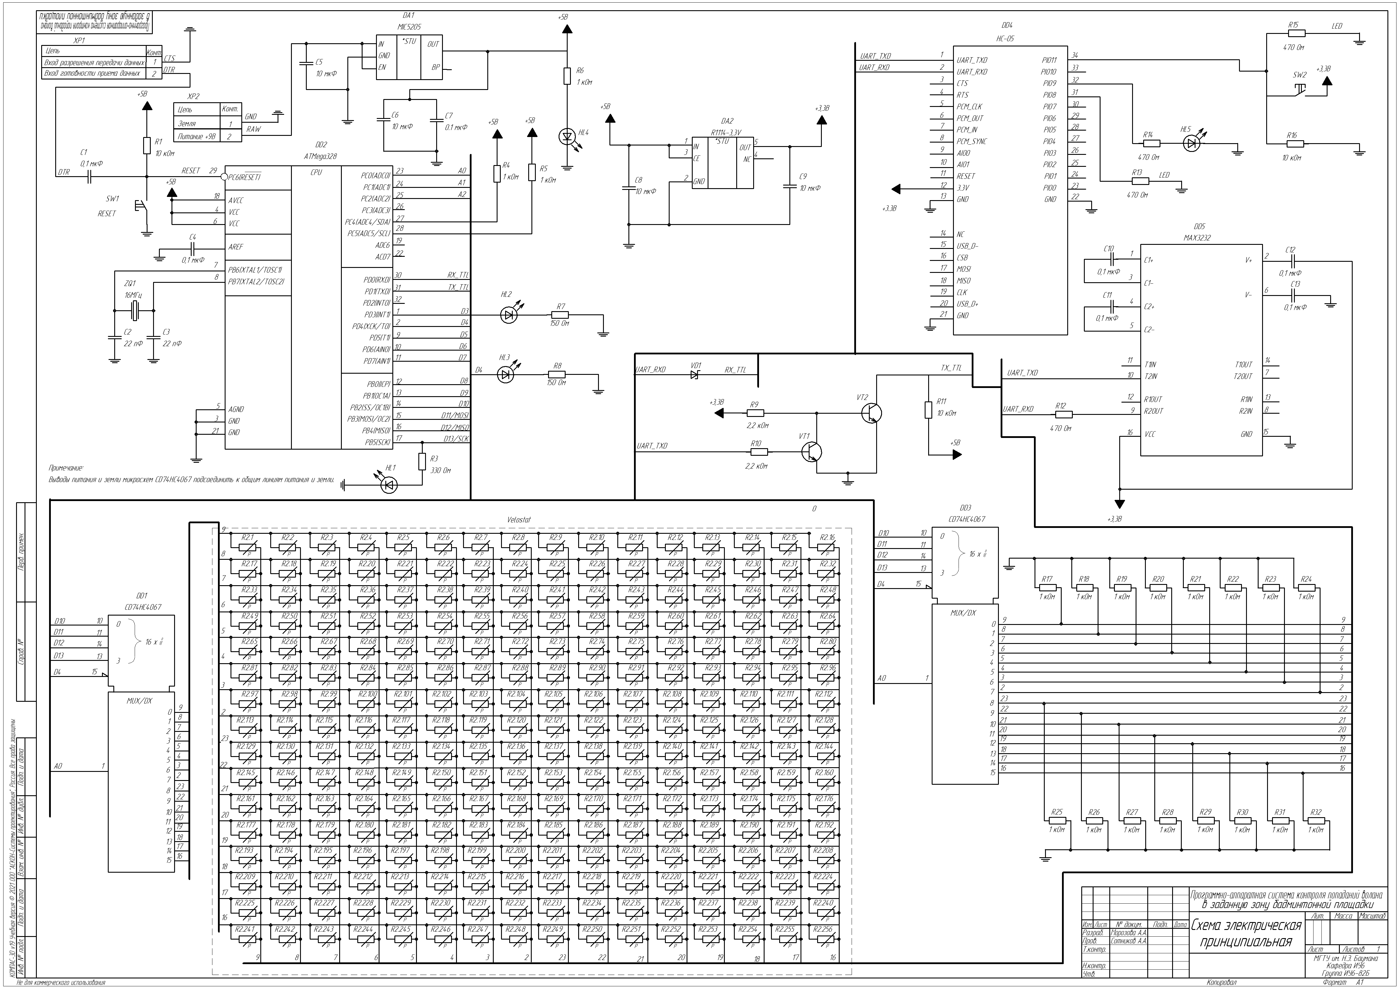
наброски/принципиальная_а1.png
