moroz-matros/badminton_training_diplom/наброски/спецификация_1.PNG

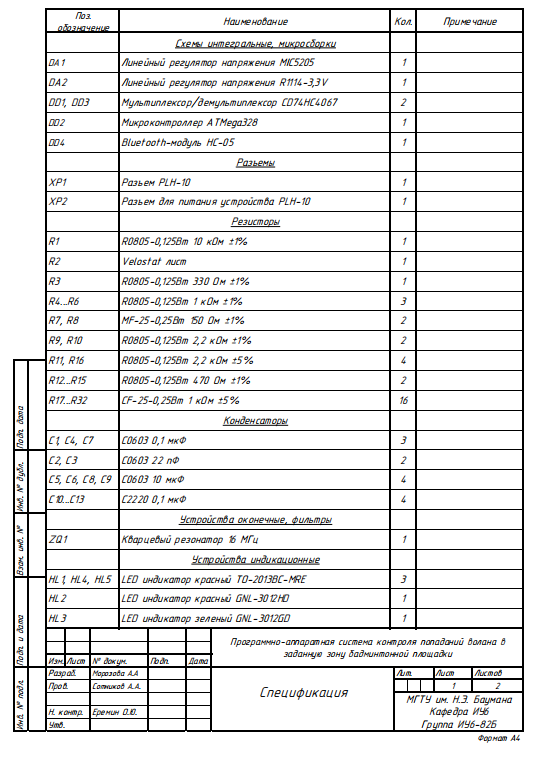
наброски/спецификация_1.PNG
