moroz-matros/badminton_training_diplom/наброски/спецификация_2.PNG

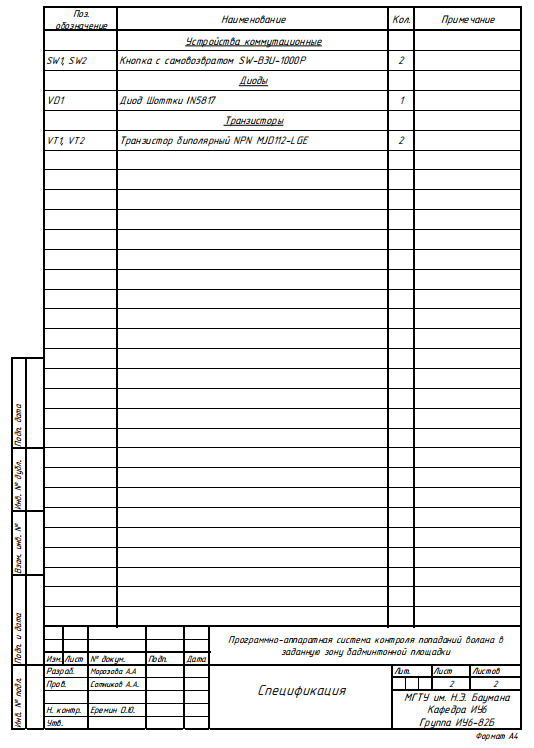
наброски/спецификация_2.PNG
