moroz-matros/badminton_training_diplom/наброски/схема.png

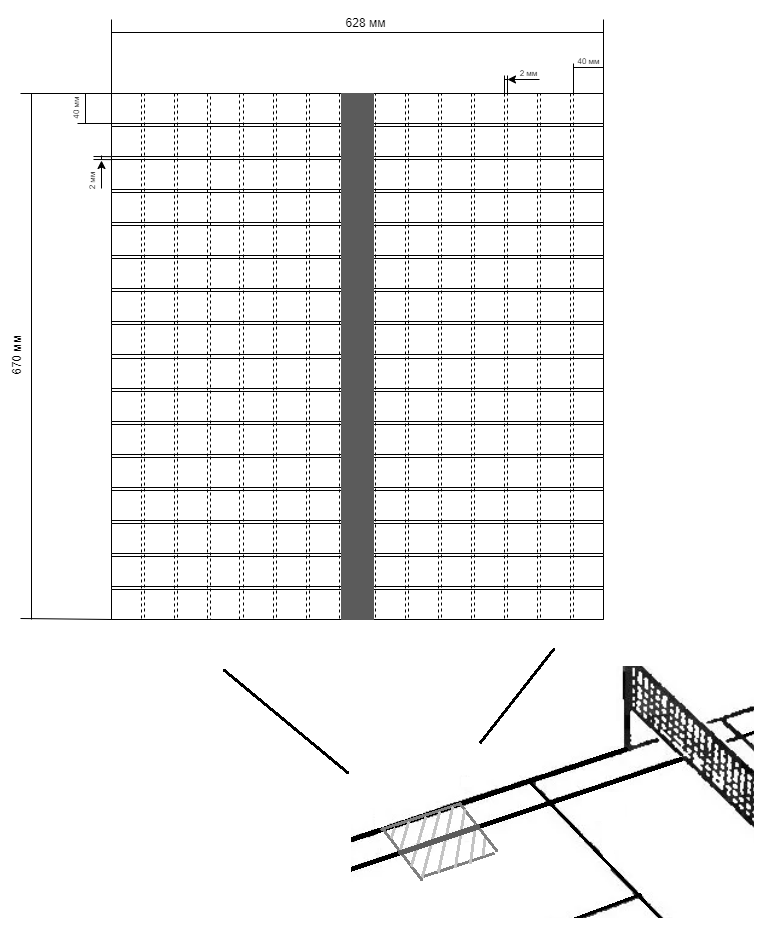
наброски/схема.png
