moroz-matros/badminton_training_diplom/наброски/схема_чистая.png

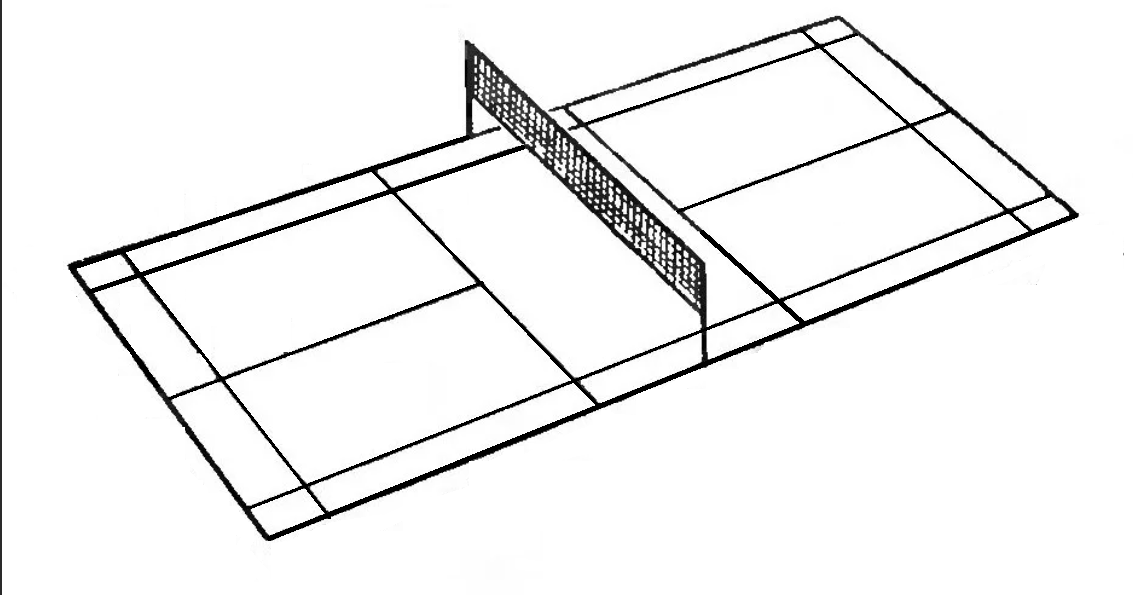
наброски/схема_чистая.png
