moroz-matros/badminton_training_diplom/наброски/технологический - тесты.png

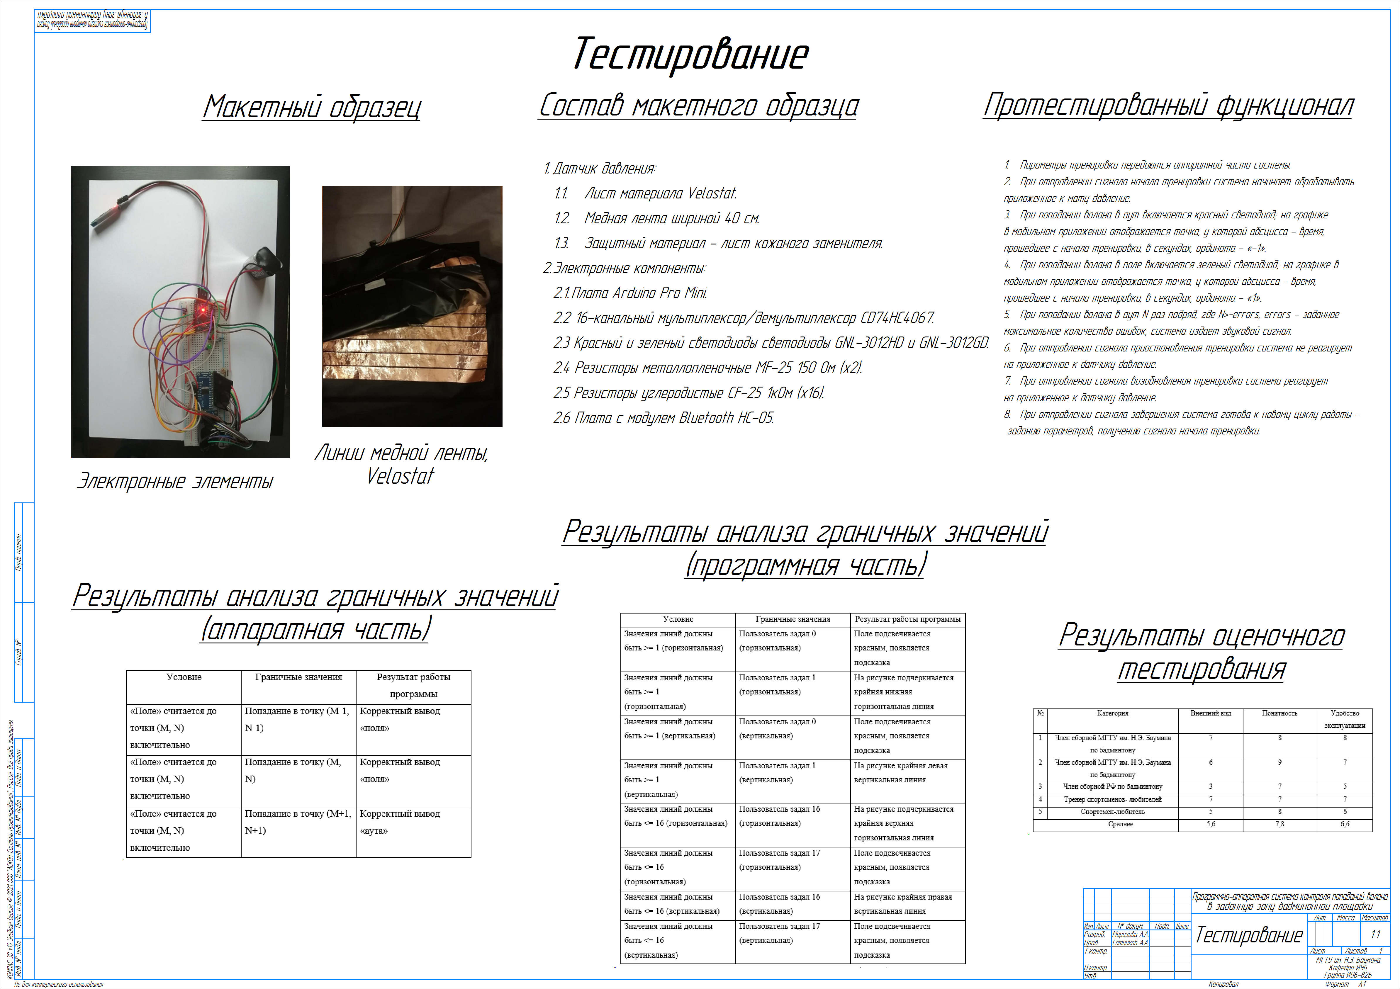
наброски/технологический - тесты.png
