moroz-matros/badminton_training_diplom/наброски/функциональная.png

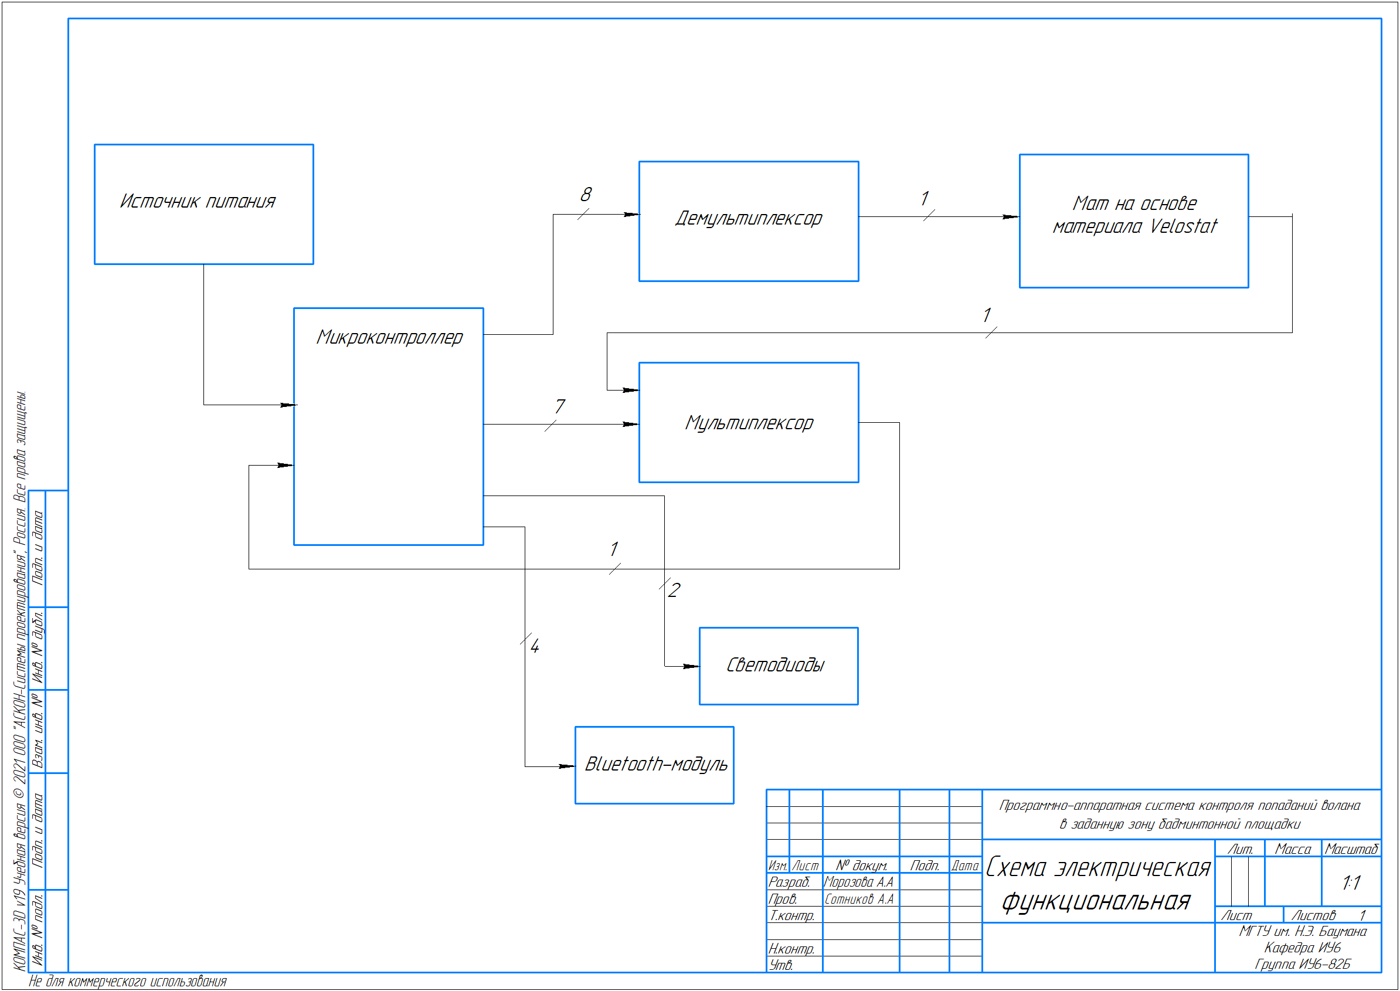
наброски/функциональная.png
