moroz-matros/badminton_training_diplom/наброски/чб 1 челлендж.jpg

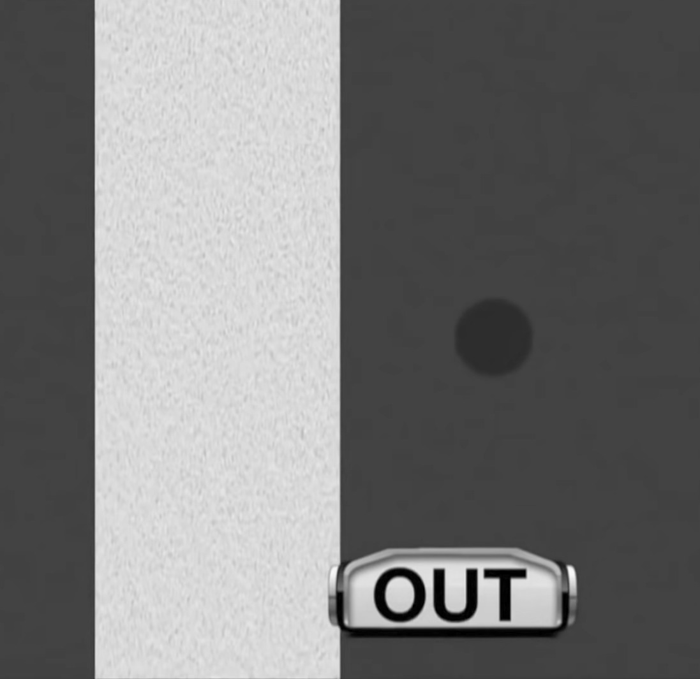
наброски/чб 1 челлендж.jpg
