moroz-matros/badminton_training_diplom/наброски/челлендж.png

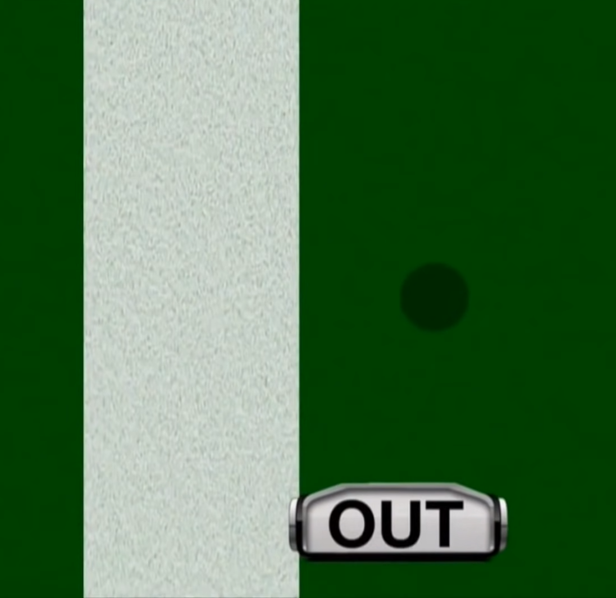
наброски/челлендж.png
