moroz-matros/badminton_training_diplom/наброски/челлендж_м2.png

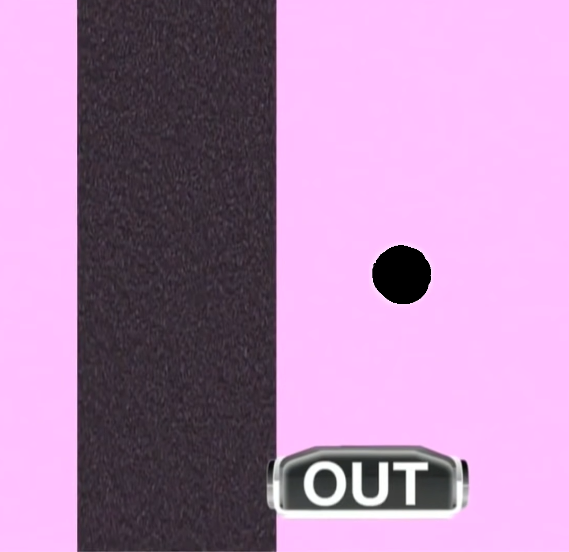
наброски/челлендж_м2.png
