moroz-matros/badminton_training_diplom/нирс/набросок.png

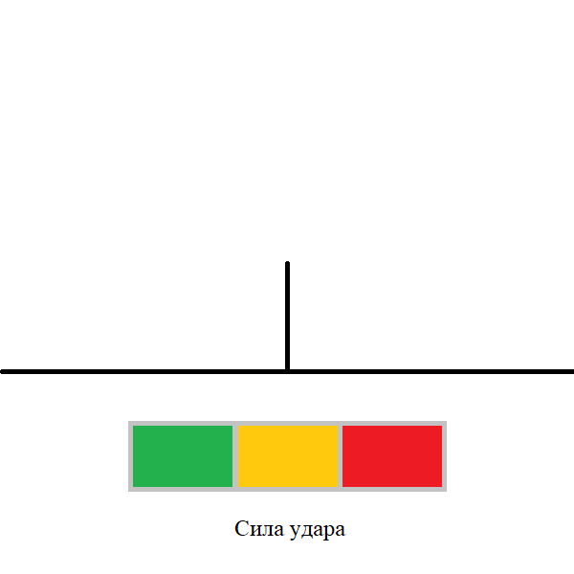
нирс/набросок.png
