moroz-matros/badminton_training_diplom/статьи/shema-pro-mini-2.jpg.webp

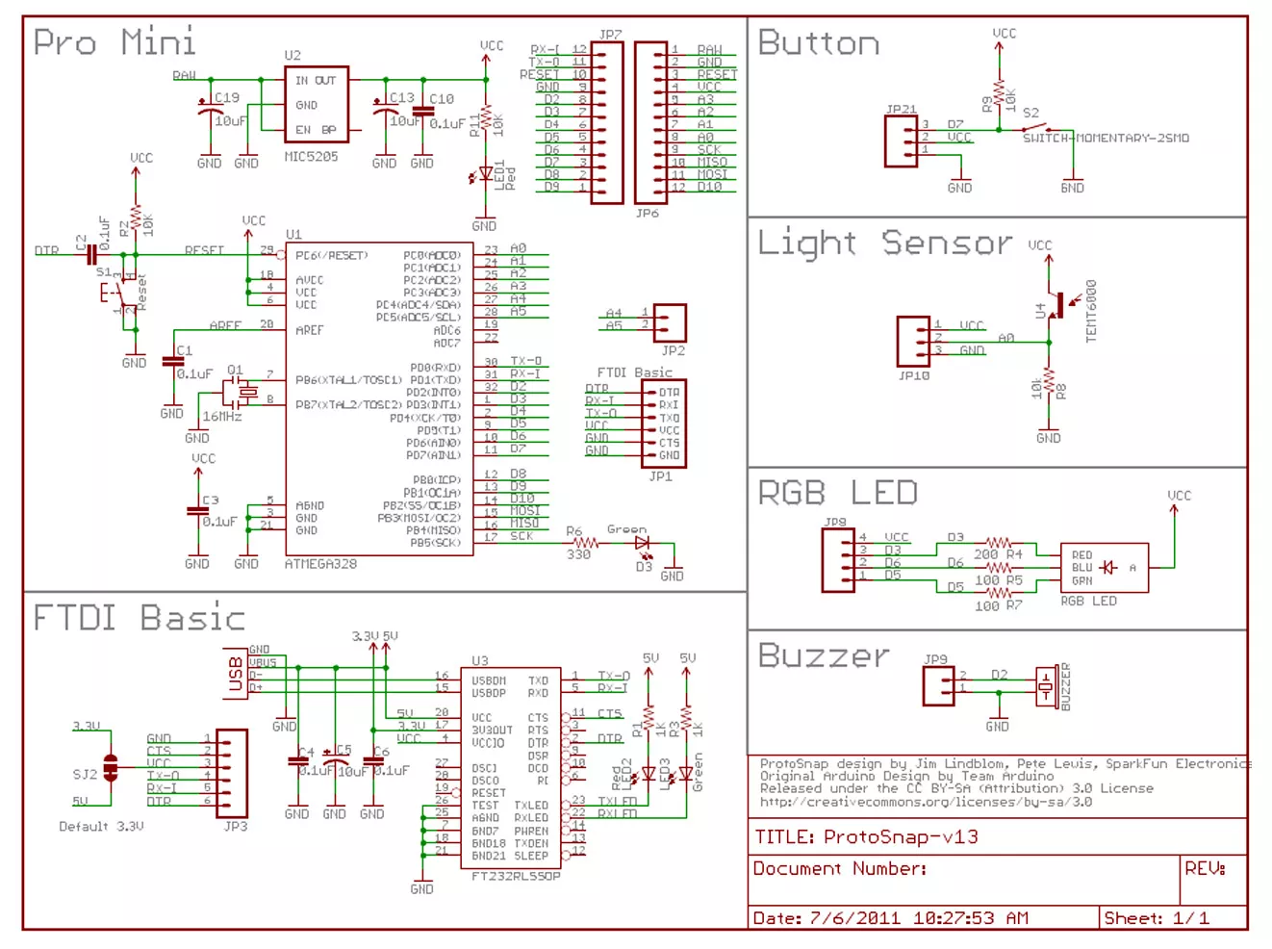
статьи/shema-pro-mini-2.jpg.webp
