moroz-matros/badminton_training_diplom/наброски/Спецификация шаблон в EXCEL_v3.xls

 | Поз. обозначение |  |  | Наименование |  |  |  | Кол. |  | Примечание
 |  |  |  | Схемы интегральные, микросборки
 | DA1 |  |  | Линейный регулятор напряжения MIC5205 |  |  |  | 1
 | DA2 |  |  | Линейный регулятор напряжения R1114-3,3V |  |  |  | 1
 | DD1, DD3 |  |  | Мультиплексор/демультиплексор CD74HC4067 |  |  |  | 2
 | DD2 |  |  | Микроконтроллер ATMega328 |  |  |  | 1
 | DD4 |  |  | Bluetooth-модуль HC-05 |  |  |  | 1
 |  |  |  | Разъемы
 | XP1 |  |  | Разъем PLH-10 |  |  |  | 1
 | XP2 |  |  | Разъем для питания устройства PLH-10 |  |  |  | 1
 |  |  |  | Резисторы
 | R1 |  |  | R0805-0,125Вт 10 кОм ±1% |  |  |  | 1
 | R2 |  |  | Velostat лист |  |  |  | 1
 | R3 |  |  | R0805-0,125Вт 330 Ом ±1% |  |  |  | 1
 | R4...R6 |  |  | R0805-0,125Вт 1 кОм ±1% |  |  |  | 3
 | R7, R8 |  |  | MF-25-0,25Вт 150 Ом ±1% |  |  |  | 2
 | R9, R10 |  |  | R0805-0,125Вт 2,2 кОм ±1% |  |  |  | 2
 | R11, R16 |  |  | R0805-0,125Вт 2,2 кОм ±5% |  |  |  | 2
 | R12...R15 |  |  | R0805-0,125Вт 470 Ом ±1% |  |  |  | 4
 | R17...R32 |  |  | CF-25-0,25Вт 1 кОм ±5% |  |  |  | 16
 |  |  |  | Конденсаторы
 | C1, C4, C7 |  |  | С0603 0,1 мкФ |  |  |  | 3
 | С2, С3 |  |  | С0603 22 пФ |  |  |  | 2
Подп. дата
 | C5, C6, C8, C9 |  |  | С0603 10 мкФ |  |  |  | 4
 | C10...C13 |  |  | С2220 0,1 мкФ |  |  |  | 4
 |  |  |  | Устройства оконечные, фильтры
 | ZQ1 |  |  | Кварцевый резонатор 16 МГц |  |  |  | 1
 |  |  |  | Устройства индикационные
Инв. № дубл. | HL1, HL4, HL5 |  |  | LED индикатор красный TO-2013BC-MRE |  |  |  | 3
 | HL2, HL3 |  |  | LED индикаторы GNL-3012HD |  |  |  | 2
 |  |  |  | Устройства коммутационные
 | SW1 |  |  | Кнопка с самовозвратом SW-B3U-1000P |  |  |  | 1
Взам. инв. №
Подп. и дата
 |  |  |  |  |  |  | Программно-аппаратная система попадания волана в заданную зону бадминтонной площадки
 | Изм. | Лист | № докум. |  | Подп. | Дата
Инв. № подл. | Разраб. |  | Морозова А.А |  |  |  | Спецификация |  | Лит. |  | Лист | Листов
 | Пров. |  | Сотников А.А. |  |  |  |  |  |  |  | 1 | 1
 |  |  |  |  |  |  |  |  | МГТУ им. Н.Э. Баумана ИУ6-72Б
 | Н. контр.
 | Утв.
 |  |  |  |  |  |  |  |  | Формат А4
