moroz-matros/badminton_training_diplom/_______/_______.ino

#define SIG_OUTPUT A1
#define S3_OUTPUT 13
#define S2_OUTPUT 12
#define S1_OUTPUT 11
#define S0_OUTPUT 10
#define EN_OUTPUT 4

#define SIG_INPUT A0
#define S3_INPUT 9
#define S2_INPUT 8
#define S1_INPUT 7
#define S0_INPUT 6
#define EN_INPUT 5

#define DIODE_GREEN 3
#define DIODE_RED 2

const int cols = 15;
const int rows = 16;

const boolean channels [16][4] {
  {0, 0, 0, 0}, //channel 0
  {1, 0, 0, 0}, //channel 1
  {0, 1, 0, 0}, //channel 2
  {1, 1, 0, 0}, //channel 3
  {0, 0, 1, 0}, //channel 4
  {1, 0, 1, 0}, //channel 5
  {0, 1, 1, 0}, //channel 6
  {1, 1, 1, 0}, //channel 7
  {0, 0, 0, 1}, //channel 8
  {1, 0, 0, 1}, //channel 9
  {0, 1, 0, 1}, //channel 10
  {1, 1, 0, 1}, //channel 11
  {0, 0, 1, 1}, //channel 12
  {1, 0, 1, 1}, //channel 13
  {0, 1, 1, 1}, //channel 14
  {1, 1, 1, 1} //channel 15
};

bool massiv[rows][cols];
int massiv2[rows][cols];

const int ledPin = 13; // Built in LED in Arduino board
String cmd;

int horizontal, vertical;
int n, err;


void setup() {
  // Initialization
  pinMode(ledPin, OUTPUT);
  digitalWrite(ledPin, LOW);
  Serial.begin(9600); // Communication rate of the Bluetooth Module


  pinMode(S0_OUTPUT, OUTPUT);
  pinMode(S1_OUTPUT, OUTPUT);
  pinMode(S2_OUTPUT, OUTPUT);
  pinMode(S3_OUTPUT, OUTPUT);

  pinMode(S0_INPUT, OUTPUT);
  pinMode(S1_INPUT, OUTPUT);
  pinMode(S2_INPUT, OUTPUT);
  pinMode(S3_INPUT, OUTPUT);

  pinMode(EN_OUTPUT, OUTPUT);
  pinMode(EN_INPUT, OUTPUT);

  pinMode(SIG_OUTPUT, OUTPUT);
  pinMode(SIG_INPUT, INPUT);

  pinMode(DIODE_RED, OUTPUT);
  pinMode(DIODE_GREEN, OUTPUT);
}

String readMsg() {
  if (Serial.available() > 0) { // Check if there is data coming
    return Serial.readString(); // Read the message as String
  }

  return " ";
}

void connect_line_rows(int i) {
  //запрещаем работу

  digitalWrite(EN_OUTPUT, HIGH);

  digitalWrite(S0_OUTPUT, channels[i][0]);
  digitalWrite(S1_OUTPUT, channels[i][1]);
  digitalWrite(S2_OUTPUT, channels[i][2]);
  digitalWrite(S3_OUTPUT, channels[i][3]);

  digitalWrite(EN_OUTPUT, LOW);
  digitalWrite(SIG_OUTPUT, HIGH);
}

void connect_line_cols(int i) {
  //запрещаем работу
  digitalWrite(EN_INPUT, HIGH);

  digitalWrite(S0_INPUT, channels[i][0]);
  digitalWrite(S1_INPUT, channels[i][1]);
  digitalWrite(S2_INPUT, channels[i][2]);
  digitalWrite(S3_INPUT, channels[i][3]);
  digitalWrite(EN_INPUT, LOW);
}

void setParameters(String msg) {
  // format "0 type noise errors"
  switch (msg[2]) {
    case '0':
      // line
      horizontal = 15;
      vertical = 7;
      break;
    case '1':
      // angle
      horizontal = 4;
      vertical = 9;
  }
  msg.remove(0, 3); // format "noise errors"
  int spaceIndex = msg.indexOf(' ');
  String noiseStr = msg.substring(0, spaceIndex);
  String errorsStr = msg.substring(spaceIndex + 1, msg.length() - 1);
  n = noiseStr.toInt();
  err = errorsStr.toInt();
  return;
}

void startTraining() {

  //необходимо пройтись по всем портам S0..S3 выхода и подать на C0..C15 платы питания высокий сигнал
  for (int i = 0; i < rows; i++) {
    connect_line_rows(i);
    for (int j = 0; j < cols; j++) {
      connect_line_cols(j);
      int val = analogRead(SIG_INPUT);
      massiv2[i][j] = val;
      if (val > n) {
        massiv[i][j] = true;
      }
    }
  }

  bool flag = false;
  int i = 0;
  int j = 0;
  for (i; i <= horizontal; j++) {
    for (j; j <= vertical; i++) {
      if (massiv[i][j] == true) {
        flag = true;
        break;
      }
    }
  }

  if (flag) {
    digitalWrite(DIODE_RED, LOW);
    digitalWrite(DIODE_GREEN, HIGH);
    String str = String("in") + String(" ") + String(i) + String(" ") + String(j);
    Serial.println(str);
    delay(500);
    return;
  } else {
    digitalWrite(DIODE_GREEN, LOW);
    digitalWrite(DIODE_RED, LOW);
  }

  for (int i = horizontal + 1; i < rows; i++) {
    for (int j = vertical + 1; j < cols; j++) {
      if (massiv[i][j] == true) {
        digitalWrite(DIODE_RED, HIGH);
        String str = String("out") + String(" ") + String(i) + String(" ") + String(j);
        Serial.println(str);
        delay(500);
        return;
      }
    }
  }

}

void pause() {
  while (readMsg()[0] != '3') {}
  return;

}

void loop() {
  String msg = readMsg();
  // 0 - set type
  // 1 - start training
  // 2 - pause
  // 3 - resume
  // 4- finish
  switch (msg[0]) {
    case '0':
      setParameters(msg);
      break;
    case '1':
      String newMsg = readMsg();
      while (newMsg[0] == " ") {
        startTraining();
      }
      switch (msg[0]) {
        case '2':
          pause();
          break;
        case '4':
          break;
      }
      break;
  }
}
