moroz-matros/badminton_training_diplom/(commit log)

2021-07-05 добавлены базовые наброски
2021-07-13 изменения в readme, добавлены наброски к исследовательской части
2021-08-31 добавлены файлы с практики
2021-09-09 добавлены заготовки для нирс и курсовой. добавлен материал в набросках по исследовательской части
